nickthelegend/hotaru/solidworks/hotaru3-poses.png

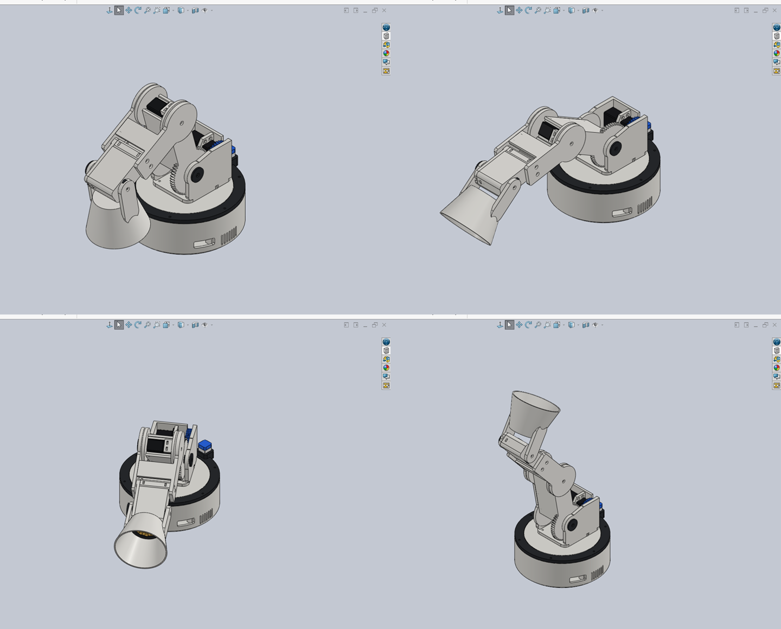
solidworks/hotaru3-poses.png
