nickthelegend/hotaru/solidworks/shots/Cap2200uF.png

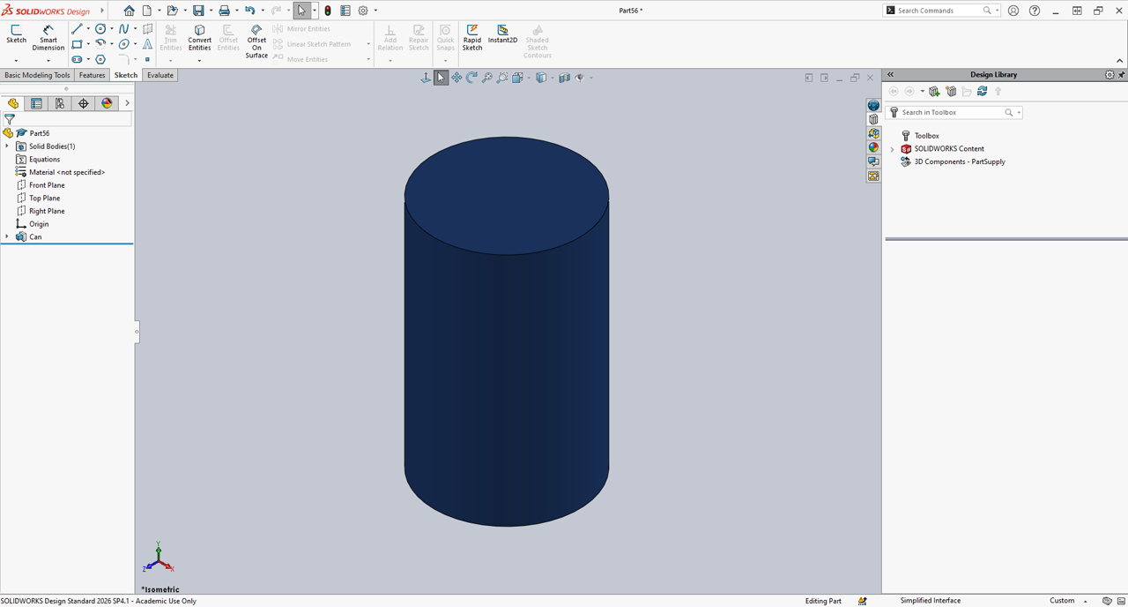
solidworks/shots/Cap2200uF.png
