nickthelegend/hotaru/solidworks/shots/CherryMX.png

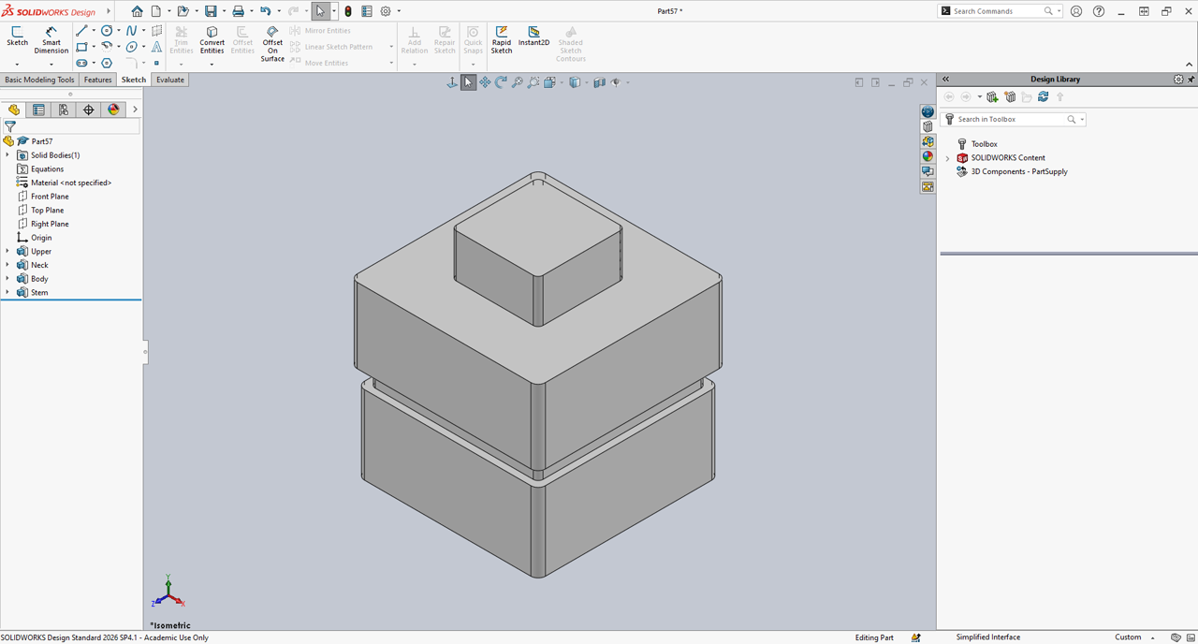
solidworks/shots/CherryMX.png
