nickthelegend/hotaru/solidworks/shots/ESP32-S3.png

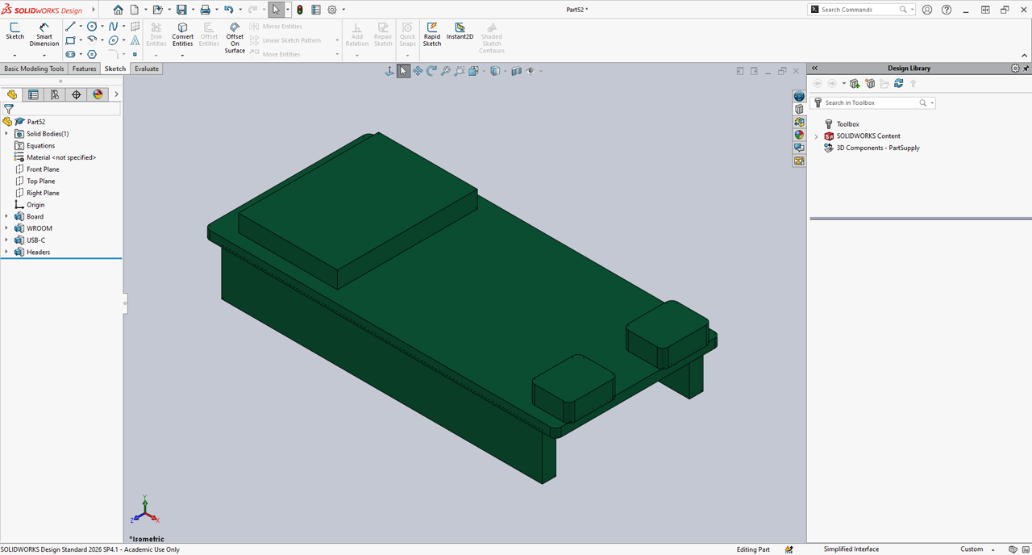
solidworks/shots/ESP32-S3.png
