nickthelegend/hotaru/solidworks/shots/h3-disc.png

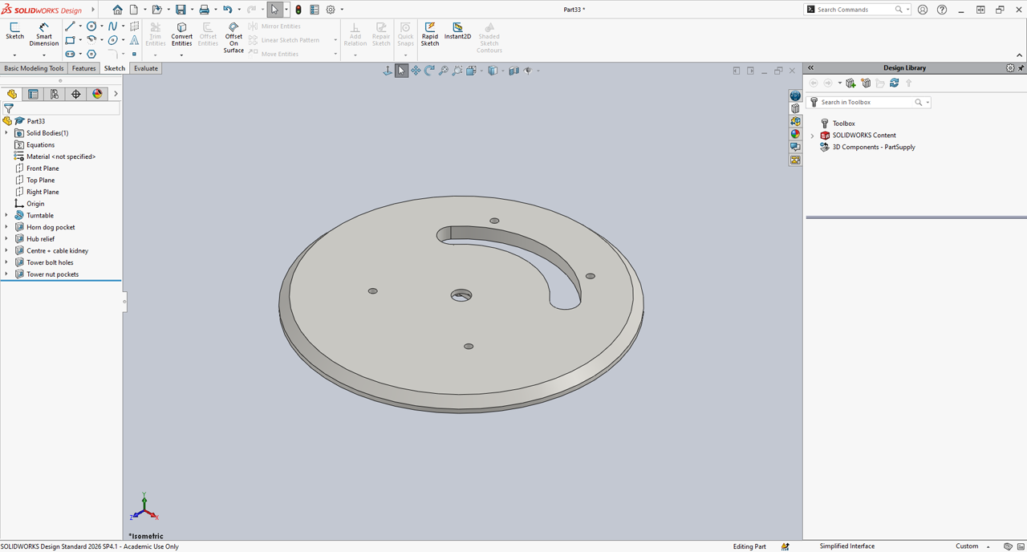
solidworks/shots/h3-disc.png
