nickthelegend/hotaru/solidworks/shots/h3-keycap.png

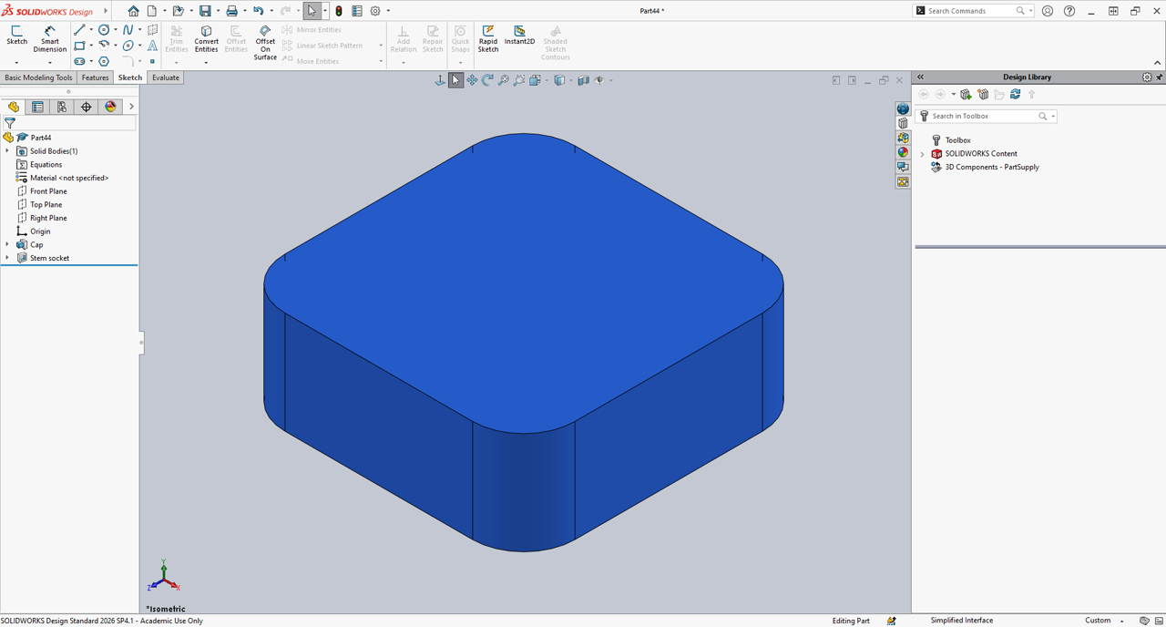
solidworks/shots/h3-keycap.png
