nickthelegend/hotaru/solidworks/shots/h3-lipring.png

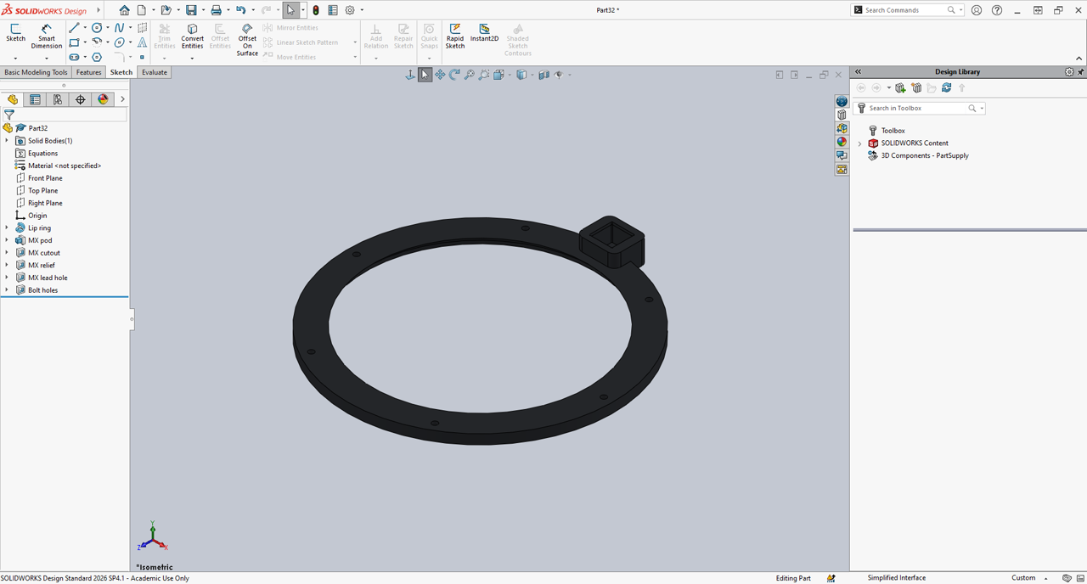
solidworks/shots/h3-lipring.png
