nickthelegend/hotaru/solidworks/shots/h3-pin-elbow.png

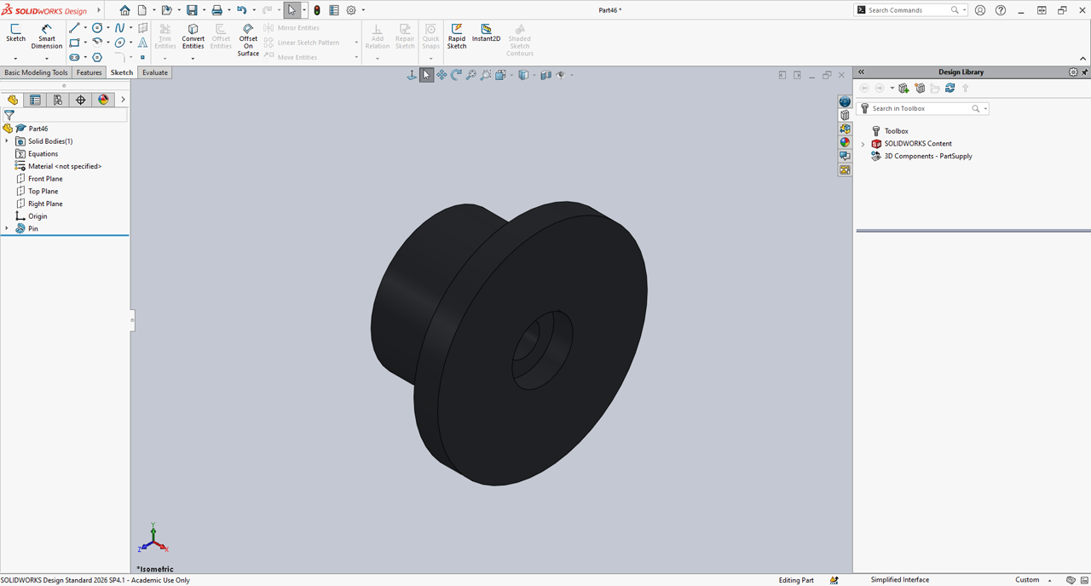
solidworks/shots/h3-pin-elbow.png
