nickthelegend/hotaru/solidworks/shots/h3-pinion.png

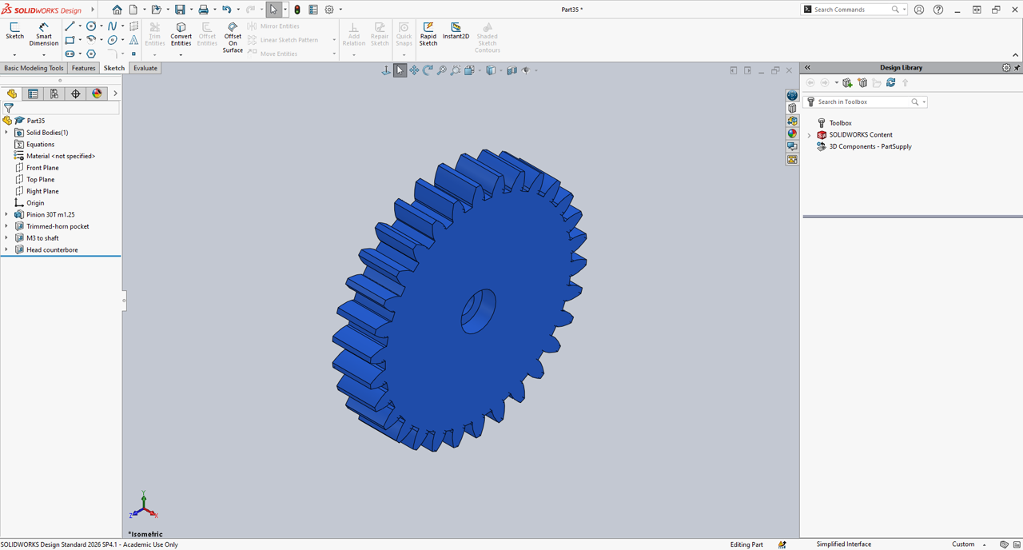
solidworks/shots/h3-pinion.png
