nickthelegend/hotaru/solidworks/shots/h3-tower-keeper.png

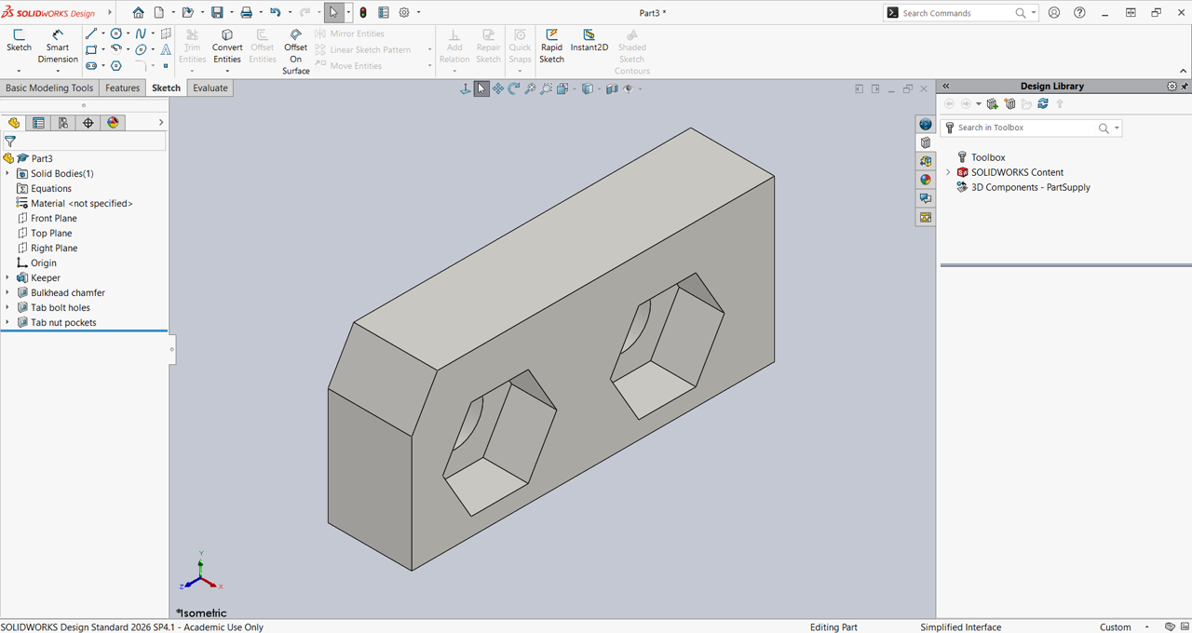
solidworks/shots/h3-tower-keeper.png
