nickthelegend/hotaru/solidworks/shots/h3-tower.png

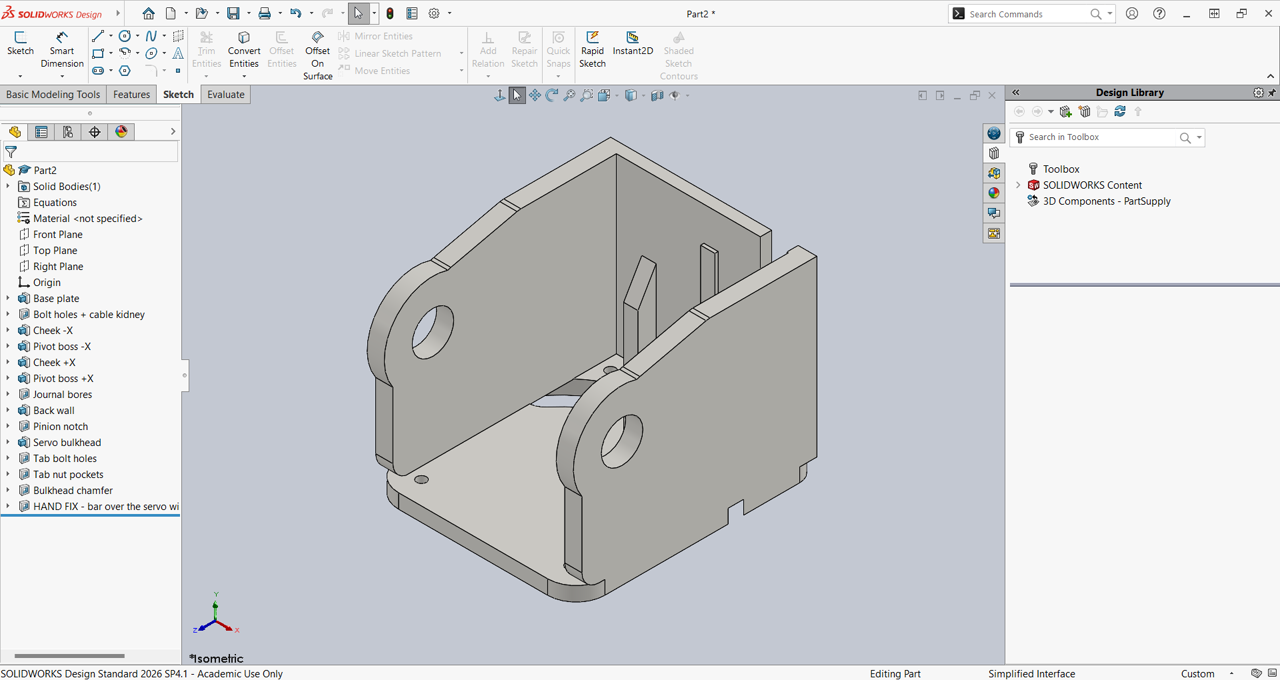
solidworks/shots/h3-tower.png
