nickthelegend/hotaru/solidworks/shots/h3-tub.png

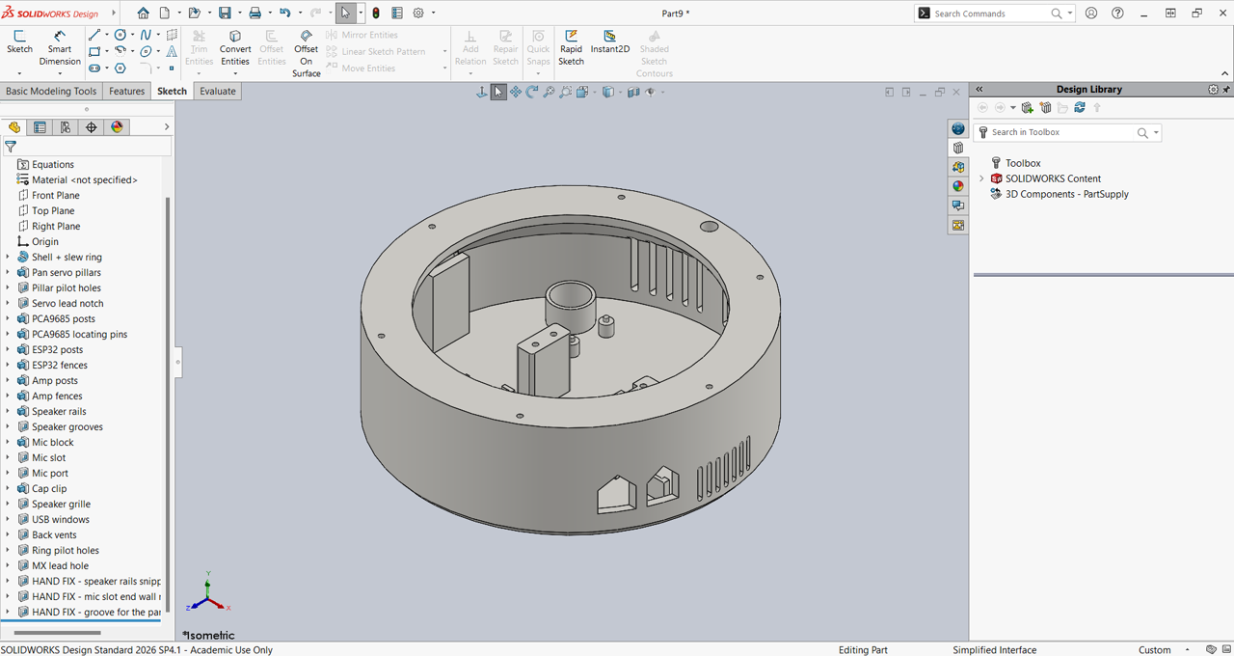
solidworks/shots/h3-tub.png
