nickthelegend/hotaru/solidworks/shots/Horn.png

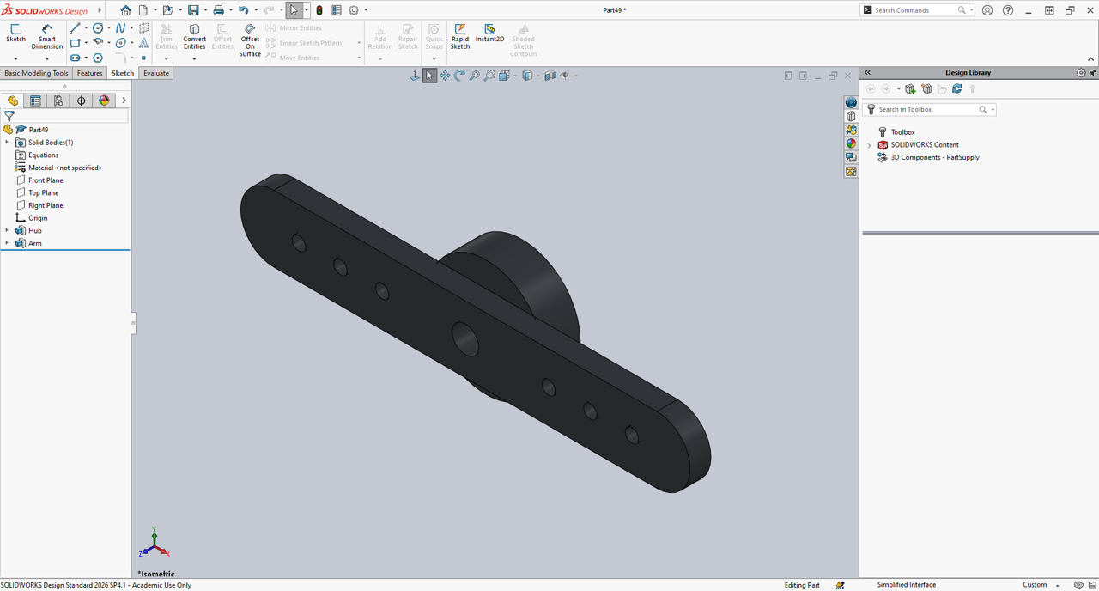
solidworks/shots/Horn.png
