nickthelegend/hotaru/solidworks/shots/HornTrim.png

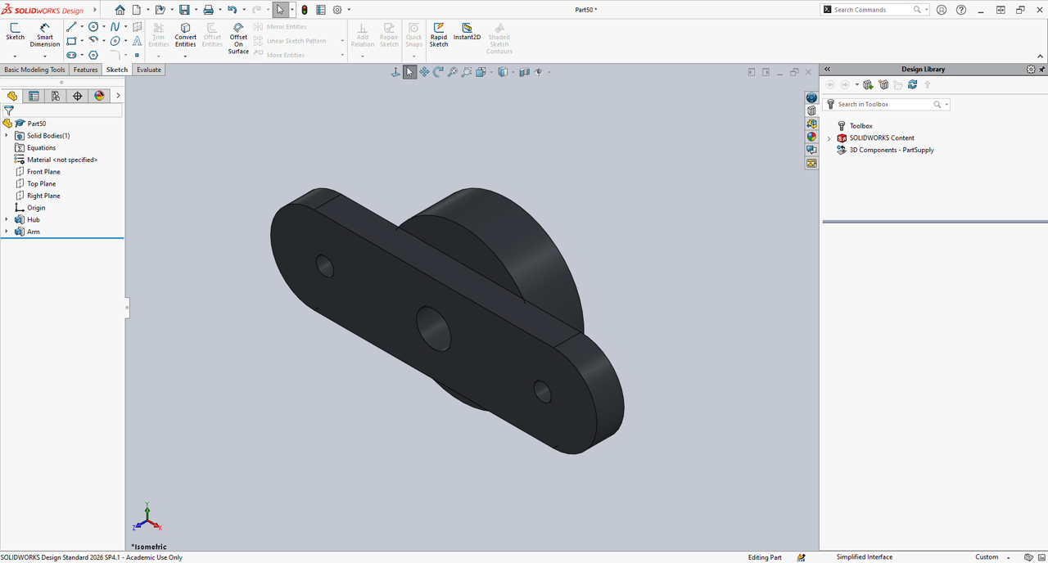
solidworks/shots/HornTrim.png
