nickthelegend/hotaru/solidworks/shots/M3-nut.png

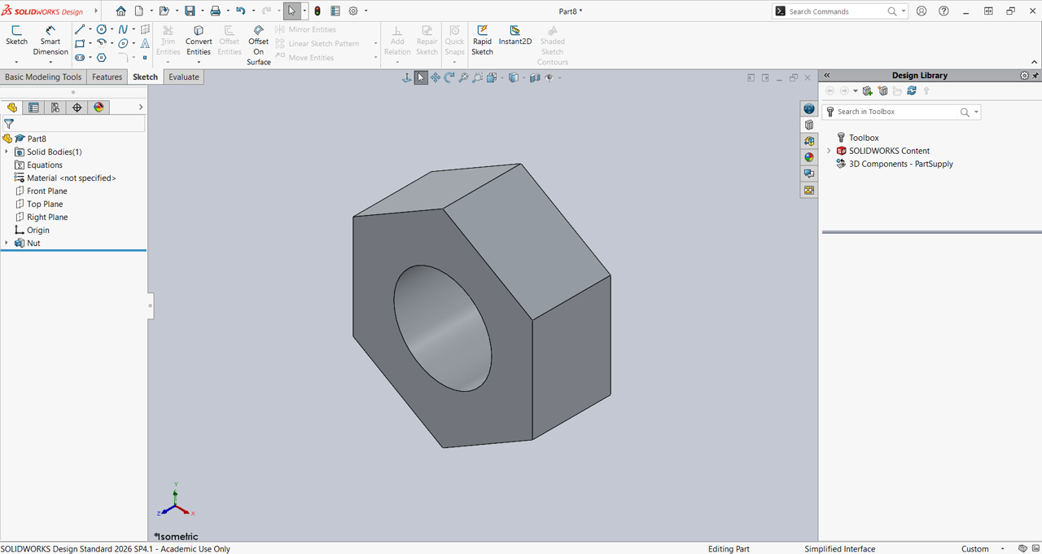
solidworks/shots/M3-nut.png
