nickthelegend/hotaru/solidworks/shots/M3x8.png

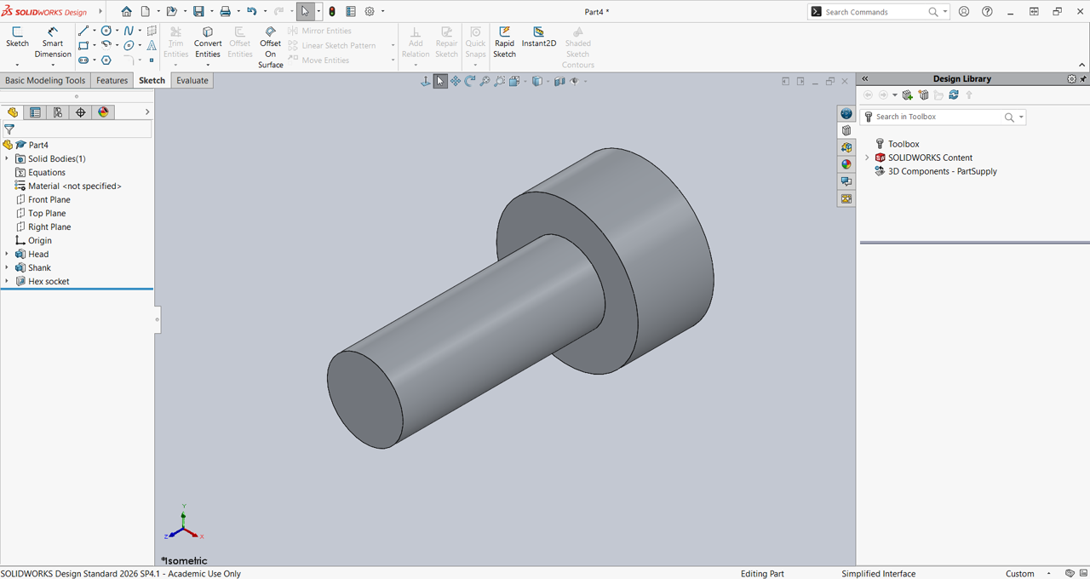
solidworks/shots/M3x8.png
