nickthelegend/hotaru/solidworks/shots/M3x12.png

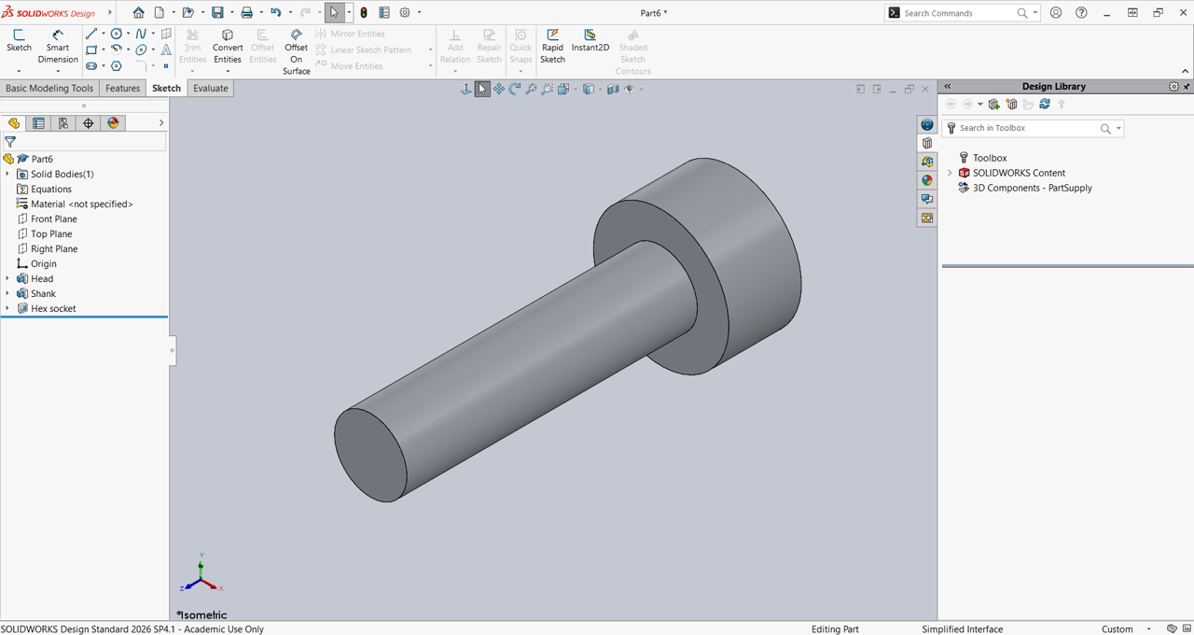
solidworks/shots/M3x12.png
