nickthelegend/hotaru/solidworks/shots/MAX98357A.png

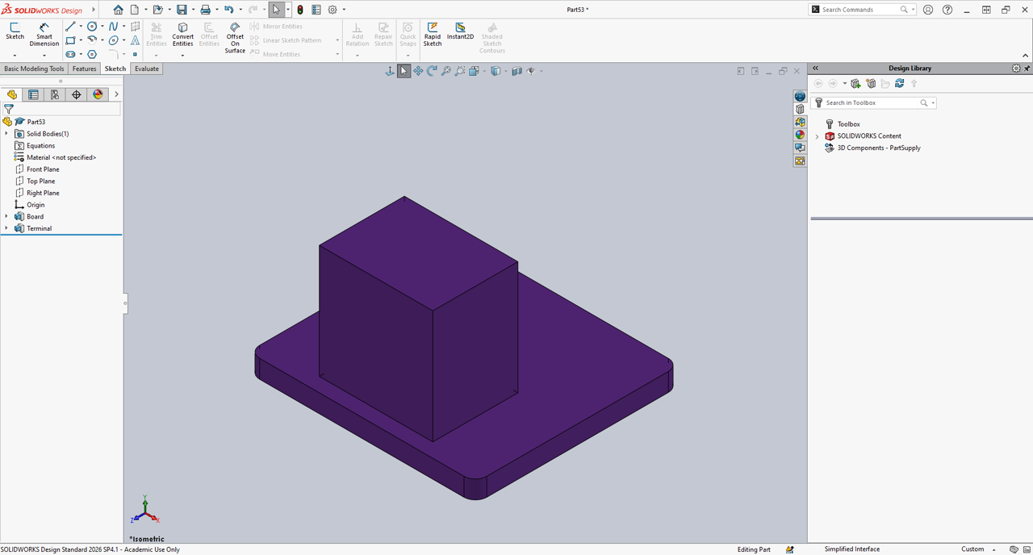
solidworks/shots/MAX98357A.png
