nickthelegend/hotaru/solidworks/shots/MG996R.png

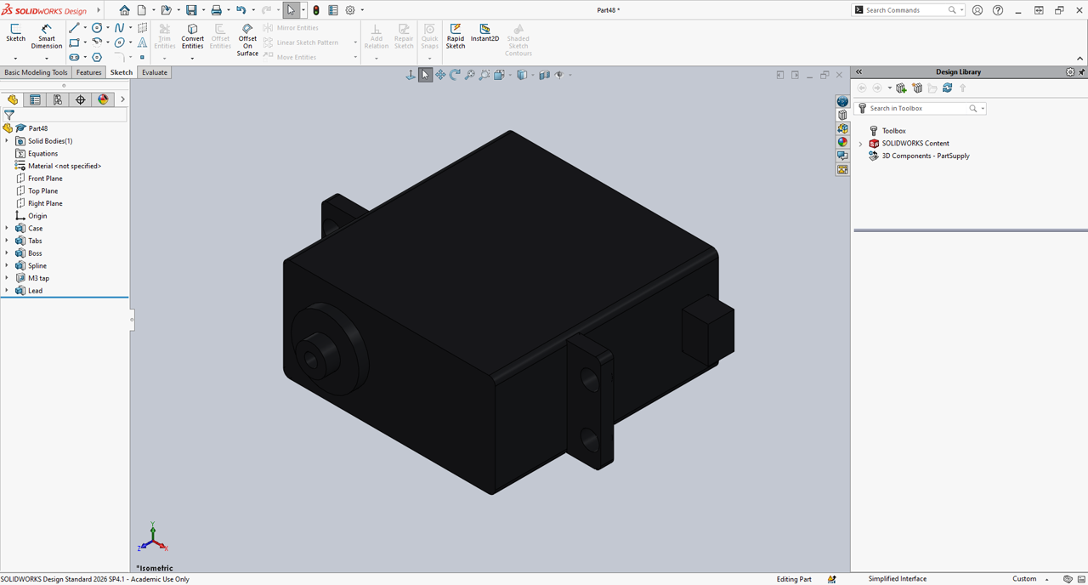
solidworks/shots/MG996R.png
