nickthelegend/hotaru/solidworks/shots/pose-curious.png

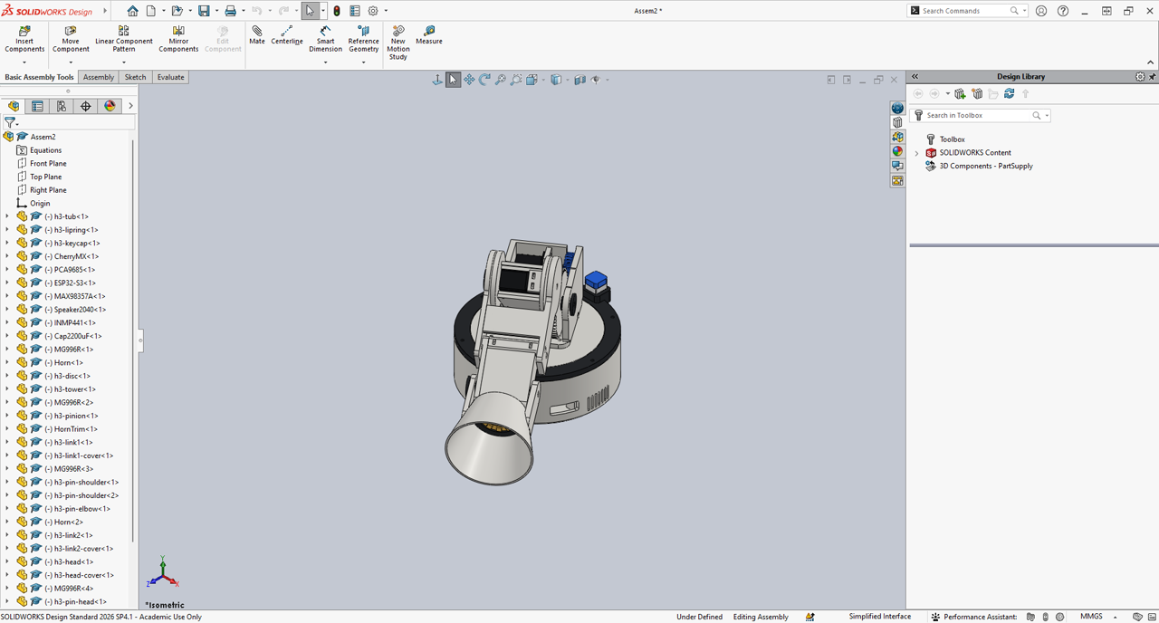
solidworks/shots/pose-curious.png
