nickthelegend/hotaru/solidworks/shots/pose-fold-back.png

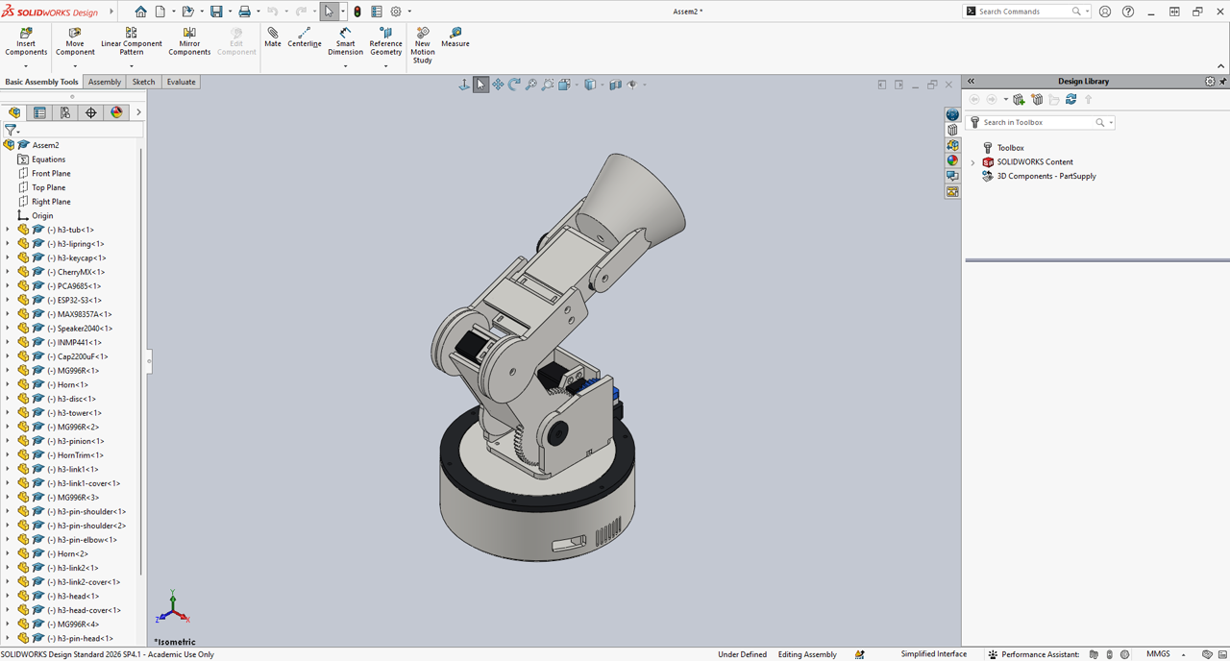
solidworks/shots/pose-fold-back.png
