nickthelegend/hotaru/solidworks/shots/pose-fold.png

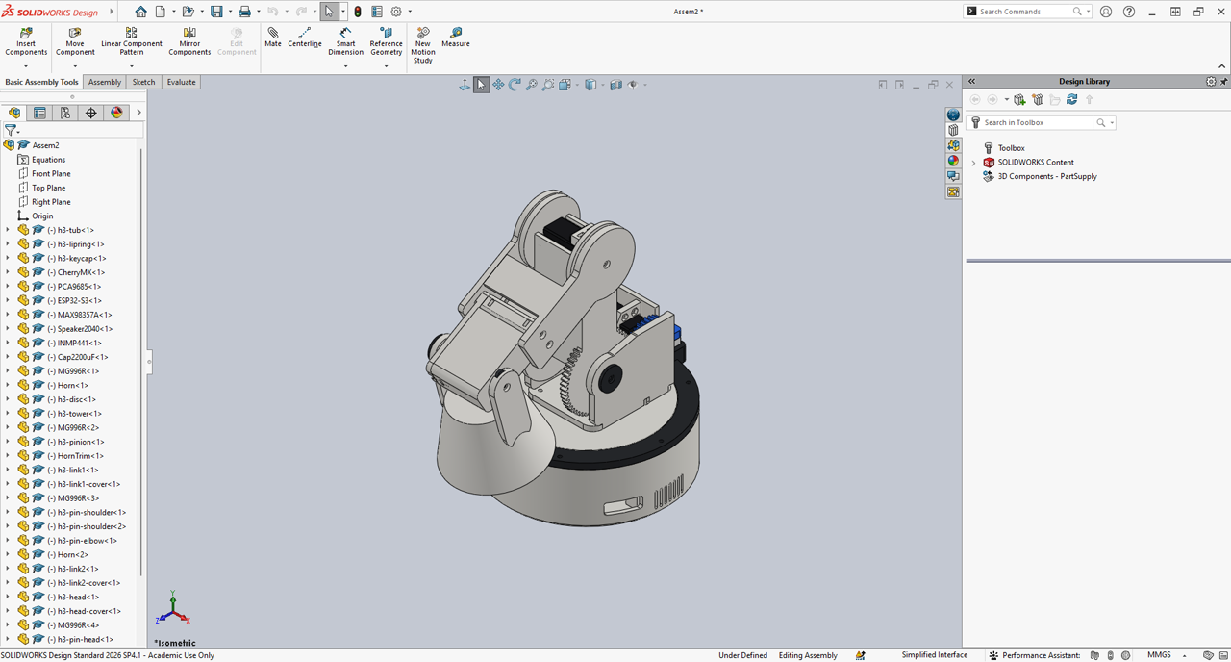
solidworks/shots/pose-fold.png
