nickthelegend/hotaru/solidworks/shots/pose-full-reach.png

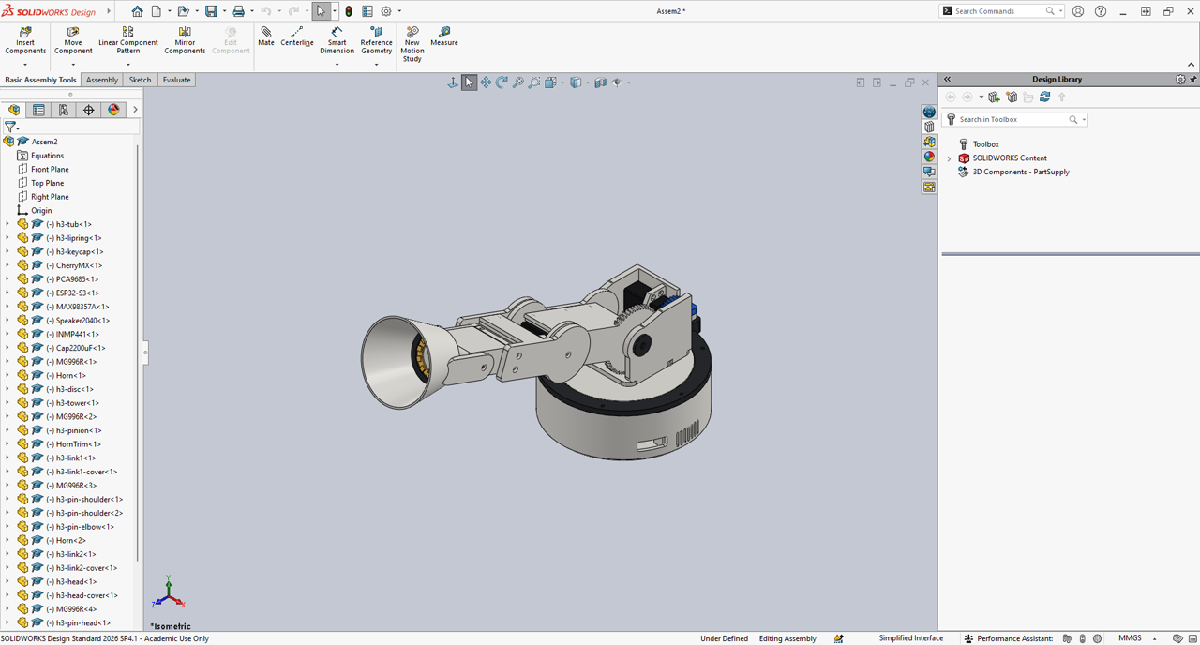
solidworks/shots/pose-full-reach.png
