nickthelegend/hotaru/solidworks/shots/pose-lean-back.png

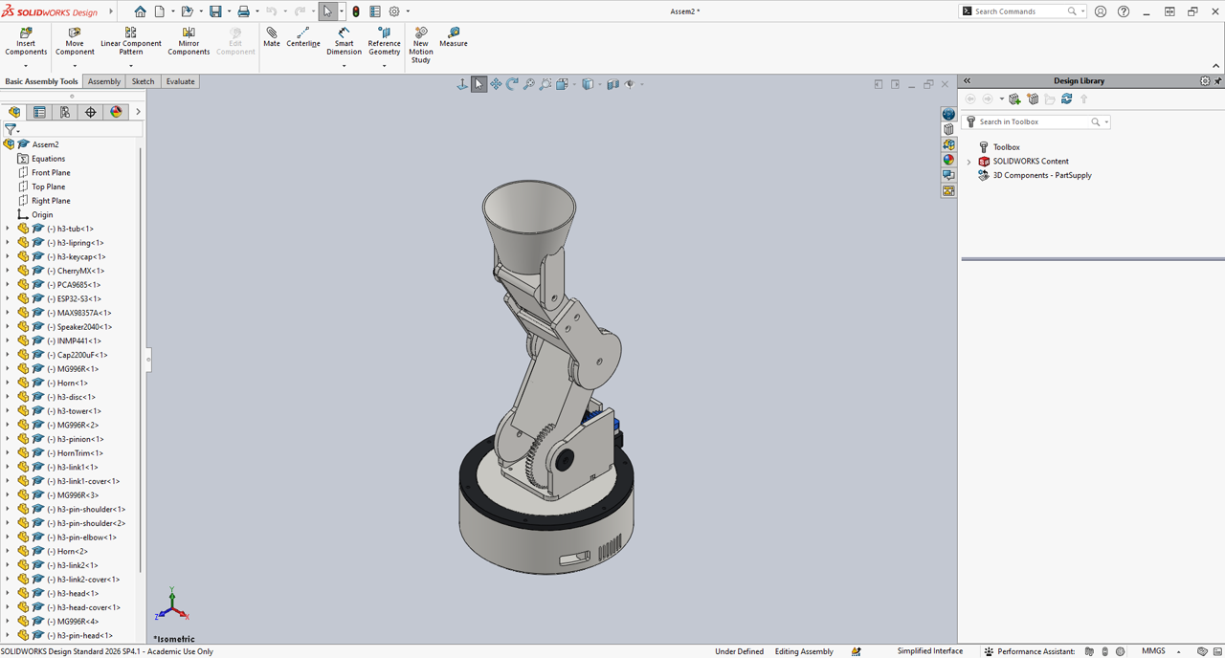
solidworks/shots/pose-lean-back.png
