nickthelegend/hotaru/solidworks/shots/Speaker2040.png

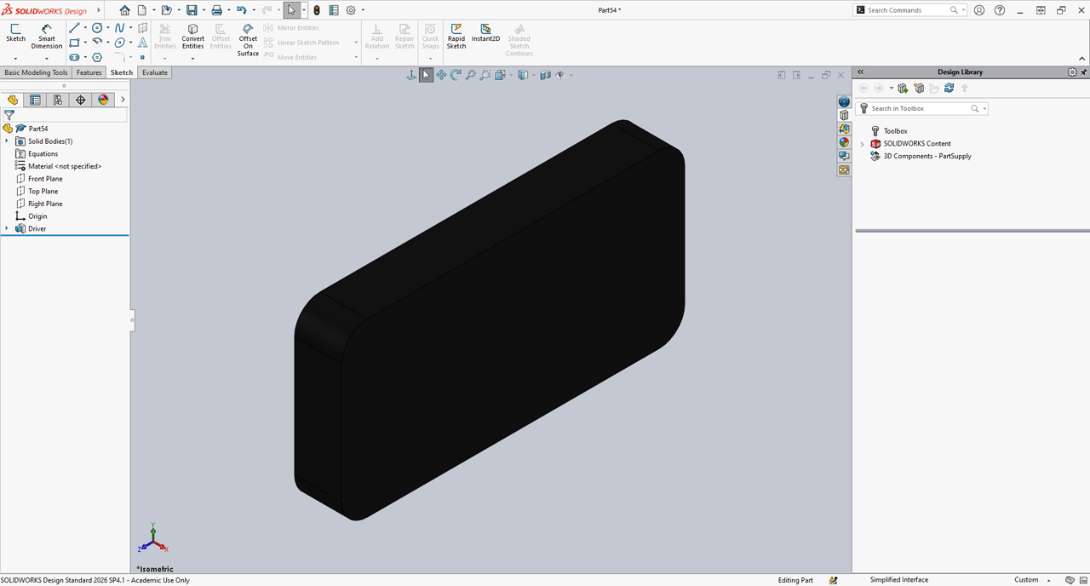
solidworks/shots/Speaker2040.png
