nickthelegend/hotaru/solidworks/HOTARU3.SLDASM

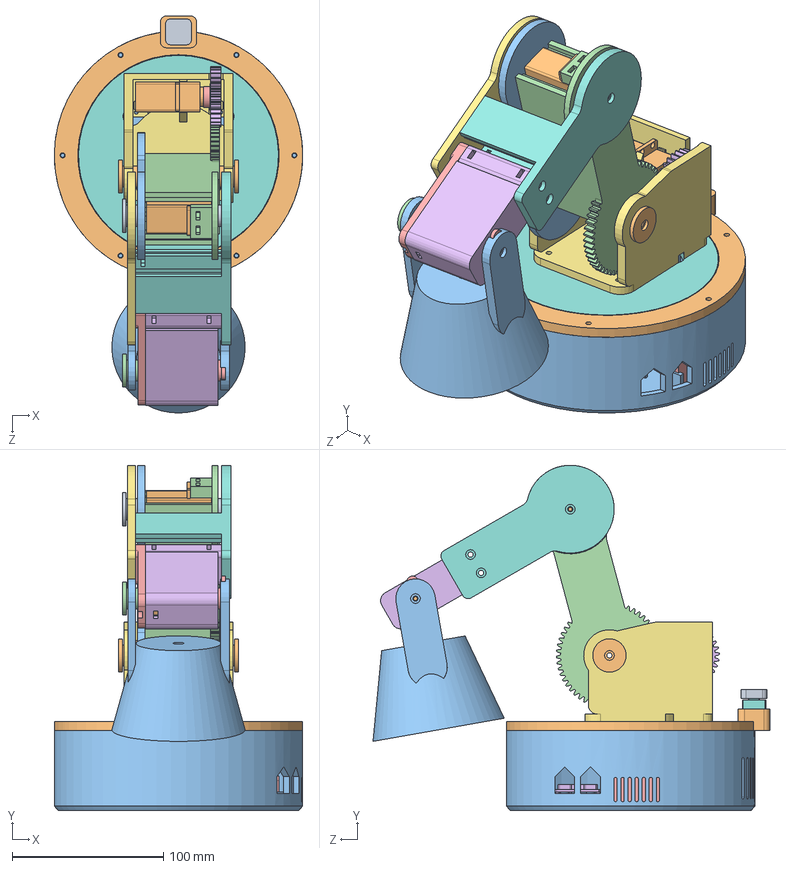
[picture p26: CAD file, 2026-09-24]
solidworks/HOTARU3.SLDASM
164.0 x 228.1 x 262.1 mm
h3-tub
h3-lipring
h3-keycap
CherryMX
PCA9685
ESP32-S3
Speaker2040
INMP441
Cap2200uF
MG996R x 4
Horn x 2
h3-disc
h3-tower
h3-pinion
HornTrim x 2
h3-link1
h3-link1-cover
h3-pin-shoulder x 2
h3-pin-elbow
h3-link2
h3-link2-cover
h3-head
h3-head-cover
h3-pin-head
h3-shade
WS2812-ring
h3-ledclamp
