nickthelegend/hotaru/exports/v3/h3-tub.STL

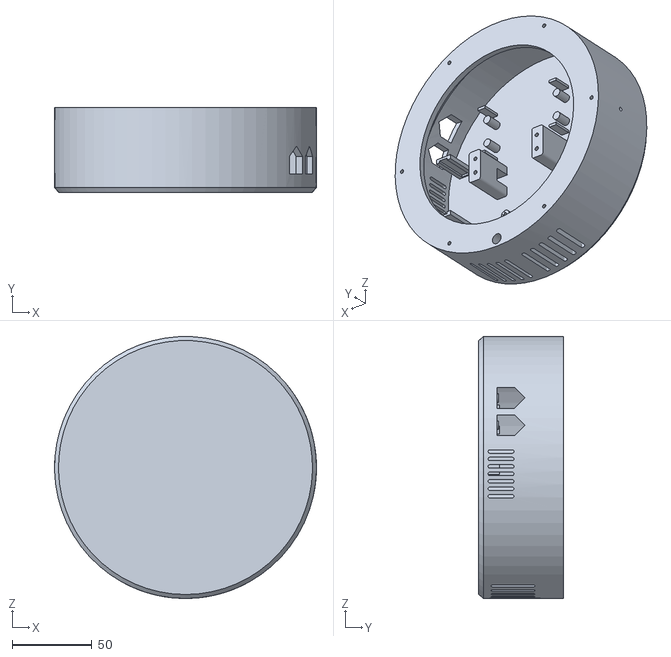
[picture p27: CAD file, 2026-10-16]
exports/v3/h3-tub.STL
164.0 x 53.0 x 164.0
