nickthelegend/hotaru/exports/v3/h3-head-cover.STL

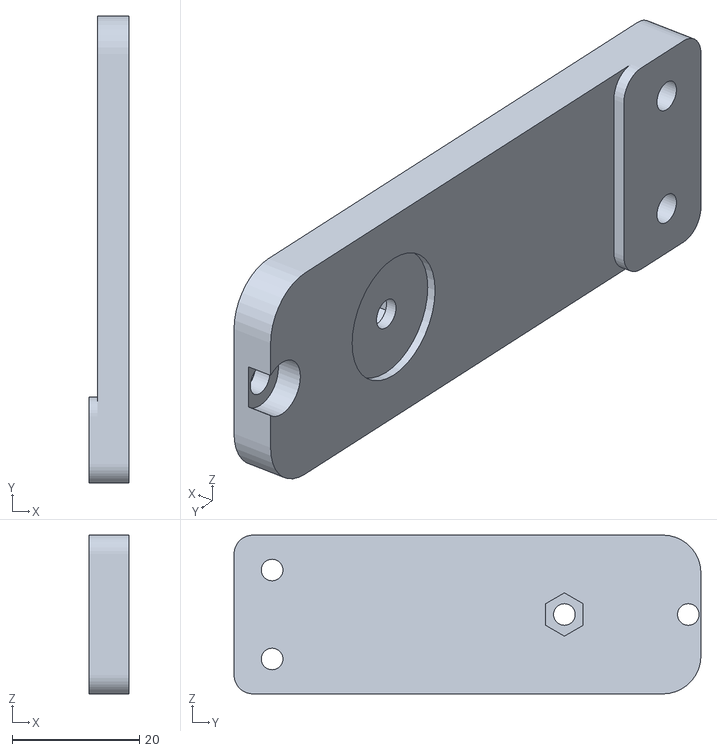
[picture p28: CAD file, 2026-09-24]
exports/v3/h3-head-cover.STL
6.35 x 73.5 x 25.0
