nickthelegend/hotaru/exports/v3/plates/HOTARU3-P1S-print-all.gcode.3mf

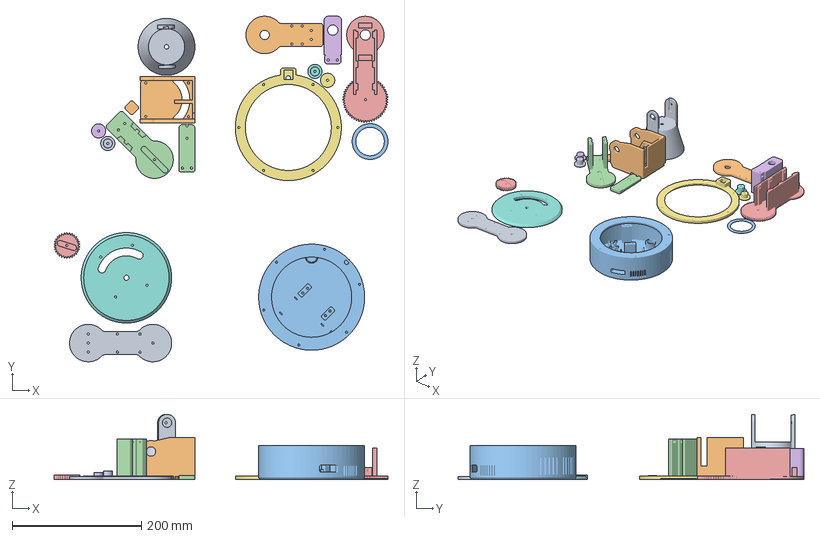
[picture p29: CAD file, 2026-10-16]
exports/v3/plates/HOTARU3-P1S-print-all.gcode.3mf
516.1 x 534.1 x 101.0 mm
h3-shade.stl
h3-tower.stl
h3-tub.stl
h3-link2.stl
h3-link1.stl
h3-head.stl
h3-lipring.stl
h3-disc.stl
h3-link1-cover.stl
h3-link2-cover.stl
h3-ledclamp.stl
h3-head-cover.stl
h3-pinion.stl
h3-pin-elbow.stl
h3-pin-head.stl
h3-pin-shoulder.stl x 2
h3-keycap.stl
