nickthelegend/hotaru/exports/v3/h3-link2.STL

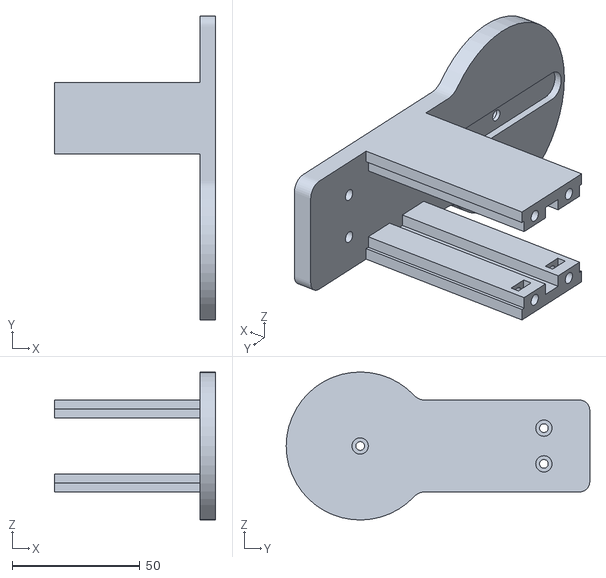
[picture p30: CAD file, 2026-09-24]
exports/v3/h3-link2.STL
63.1 x 119.0 x 58.0
