nickthelegend/hotaru/exports/v3/h3-ledclamp.STL

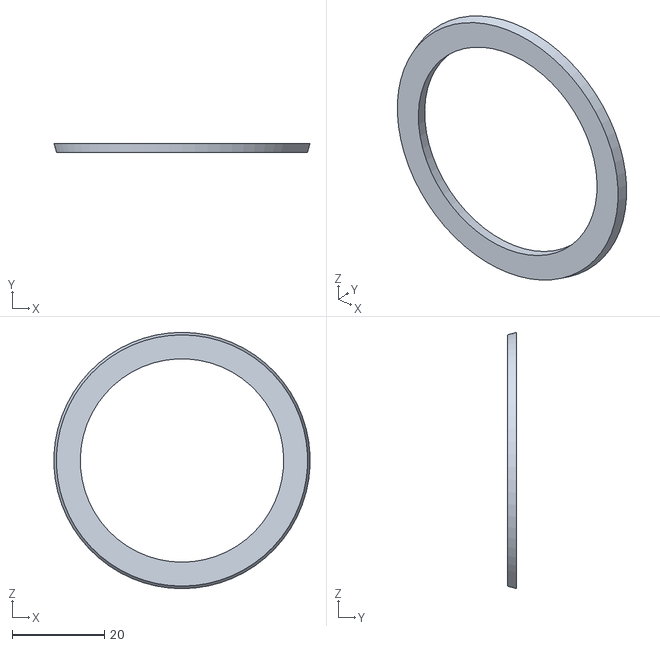
[picture p31: CAD file, 2026-09-24]
exports/v3/h3-ledclamp.STL
55.4 x 2.00 x 55.5
