nickthelegend/hotaru/exports/v3/h3-shade.STL

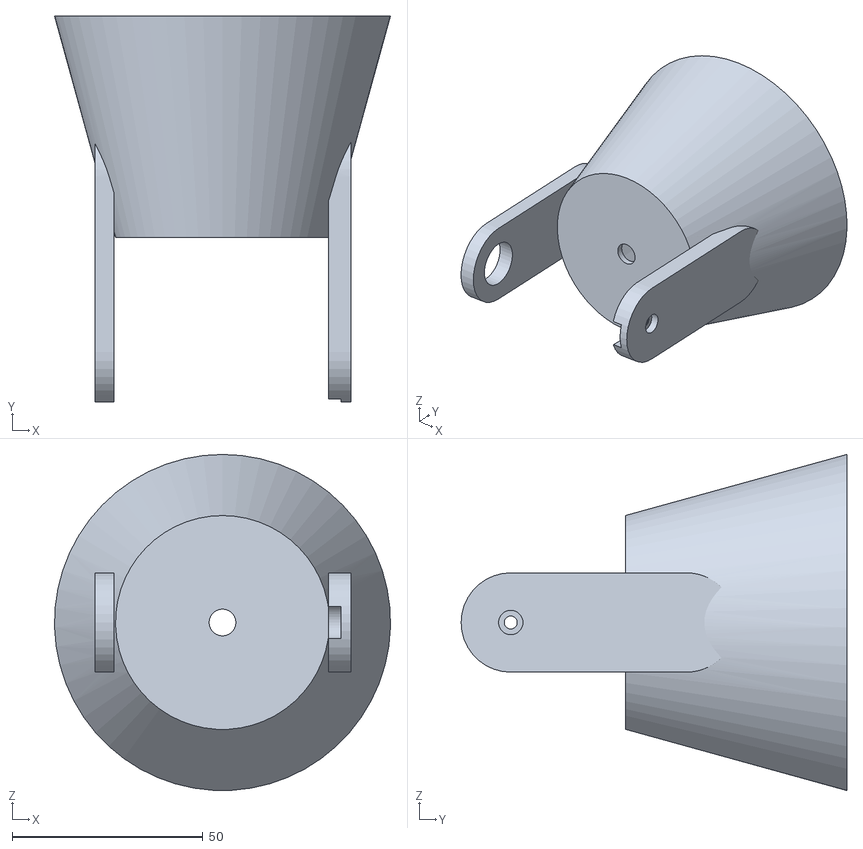
[picture p32: CAD file, 2026-09-24]
exports/v3/h3-shade.STL
88.0 x 101.0 x 88.0
