nickthelegend/hotaru/solidworks/parts/h3-tower-keeper.SLDPRT

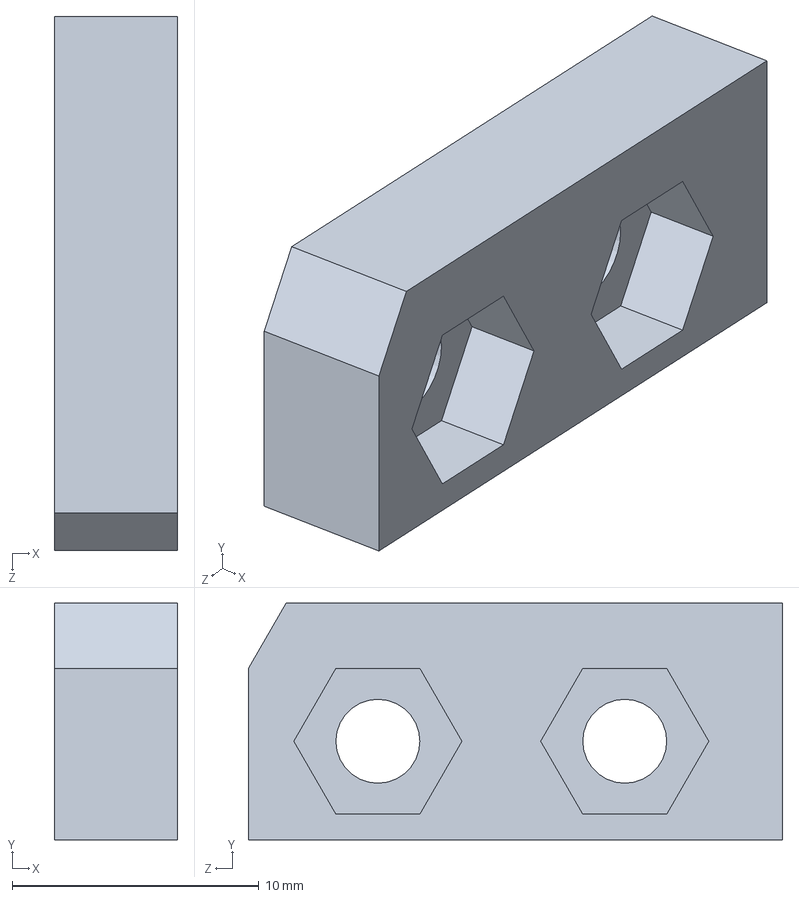
[picture p33: CAD file, 2026-10-16]
solidworks/parts/h3-tower-keeper.SLDPRT
5.00 x 9.60 x 21.7 mm
