nickthelegend/hotaru/exports/v3/h3-pinion.STL

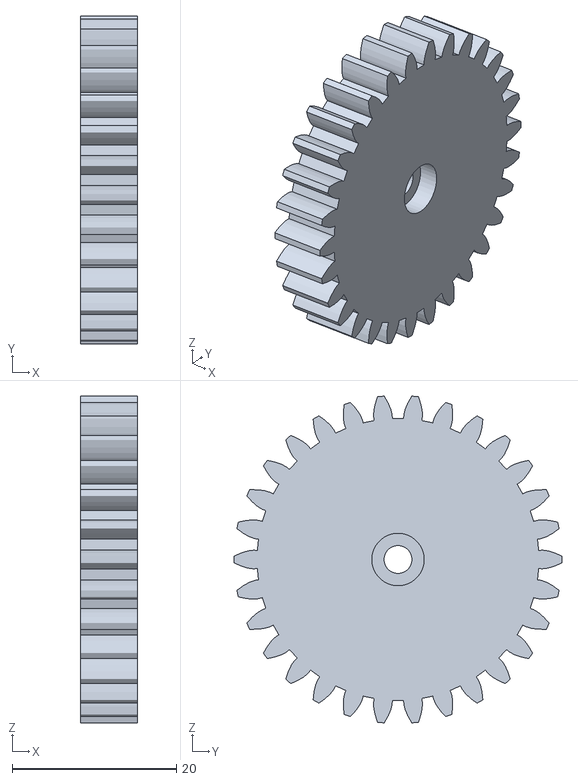
[picture p34: CAD file, 2026-09-24]
exports/v3/h3-pinion.STL
7.00 x 40.0 x 39.9
