nickthelegend/hotaru/exports/v3/plates/plate-3-turntable.3mf

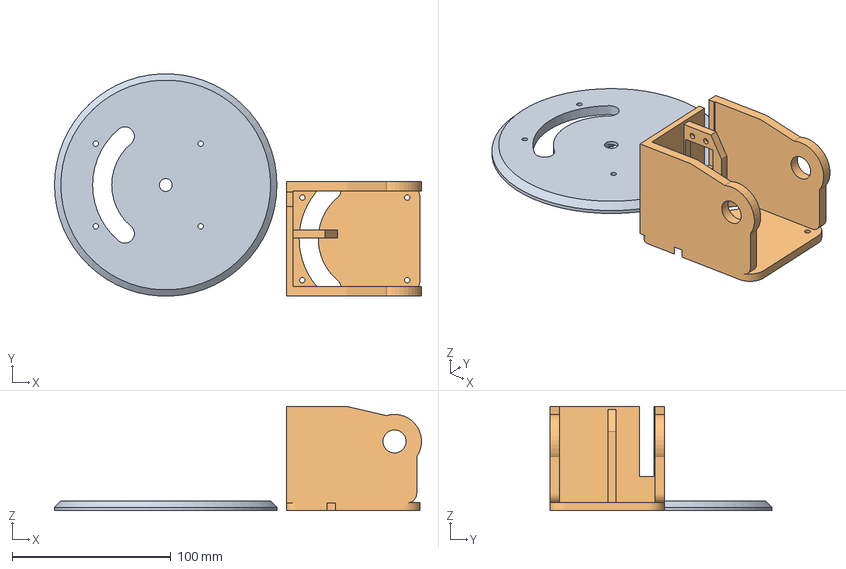
[picture p35: CAD file, 2026-09-24]
exports/v3/plates/plate-3-turntable.3mf
231.0 x 139.8 x 65.5 mm
h3-disc
h3-tower
