nickthelegend/hotaru/exports/v3/h3-tower.STL

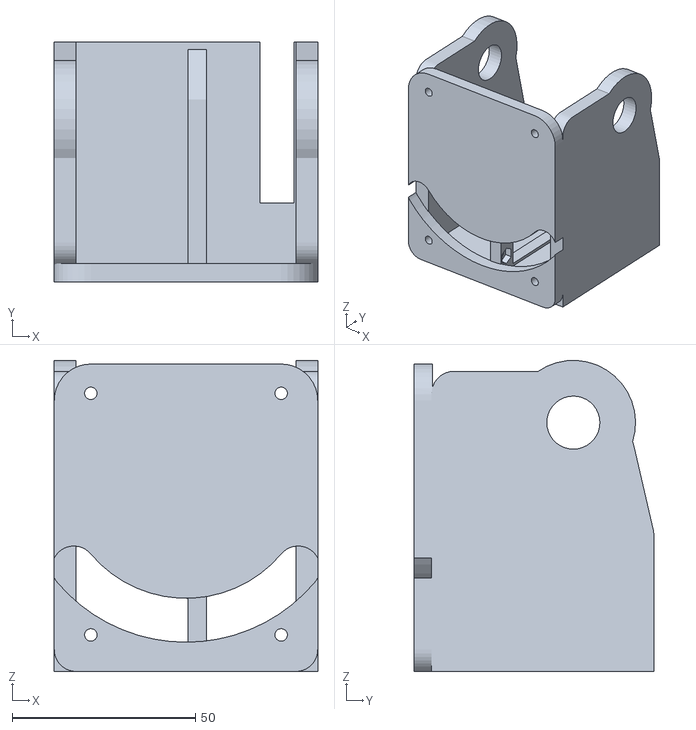
[picture p36: CAD file, 2026-09-24]
exports/v3/h3-tower.STL
72.0 x 65.5 x 85.0
