nickthelegend/hotaru/exports/v3/plates/plate-4-arm.3mf

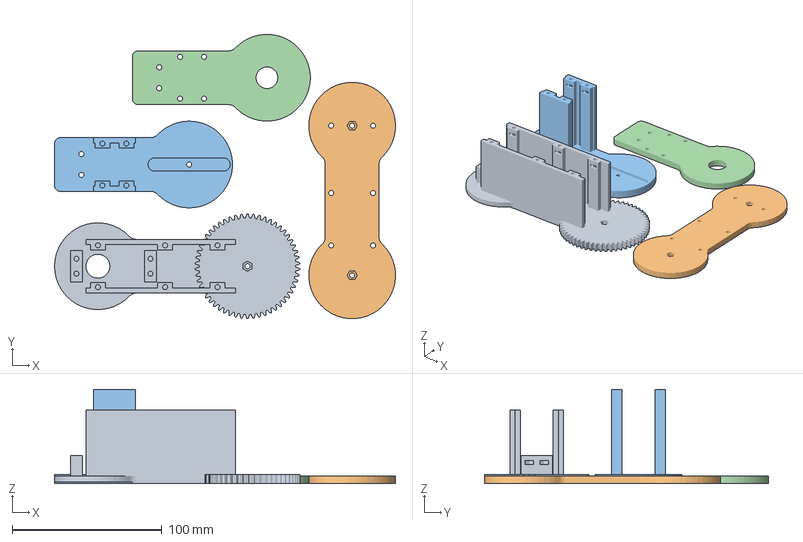
[picture p37: CAD file, 2026-09-24]
exports/v3/plates/plate-4-arm.3mf
227.9 x 190.0 x 63.1 mm
h3-link1
h3-link1-cover
h3-link2
h3-link2-cover
