nickthelegend/hotaru/solidworks/parts/h3-tub.SLDPRT

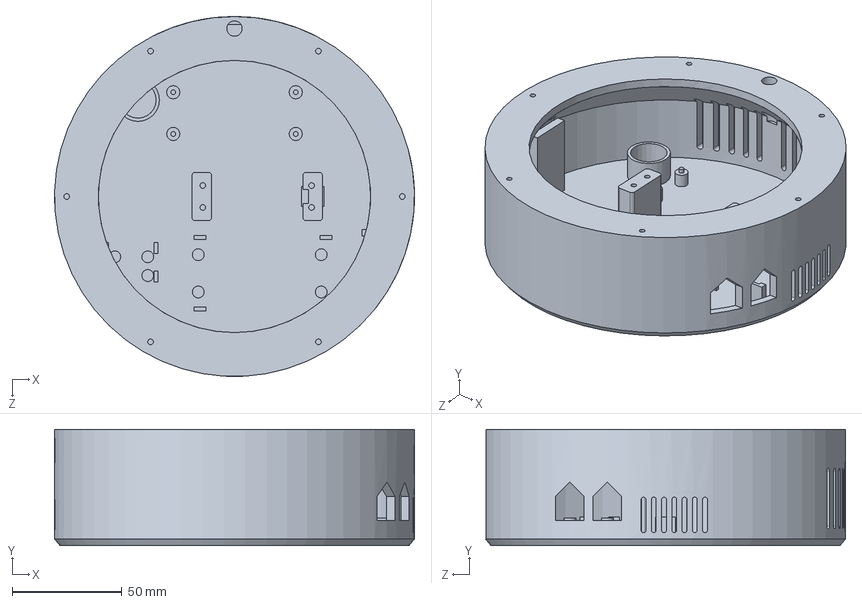
[picture p38: CAD file, 2026-10-16]
solidworks/parts/h3-tub.SLDPRT
164.0 x 53.0 x 164.0 mm
