nickthelegend/hotaru/exports/v3/h3-link1-cover.STL

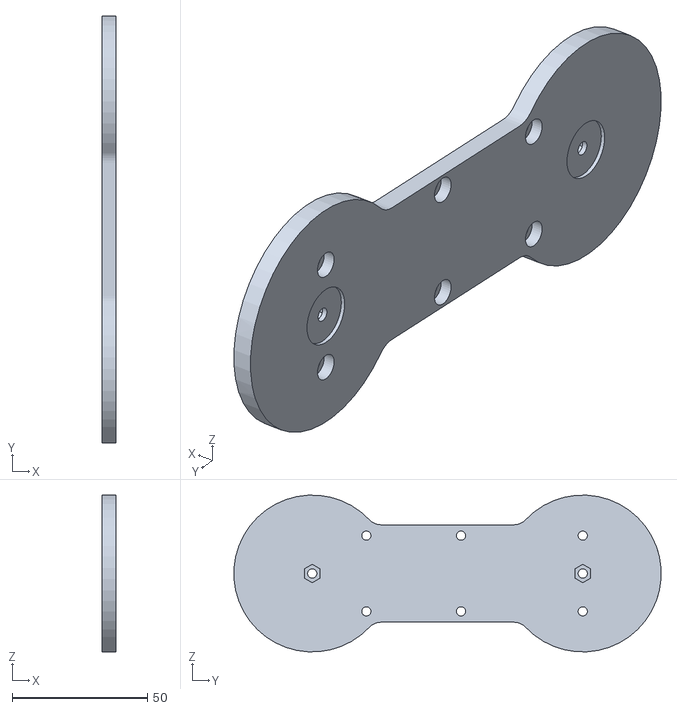
[picture p39: CAD file, 2026-09-24]
exports/v3/h3-link1-cover.STL
5.00 x 157.8 x 57.9
