nickthelegend/hotaru/exports/v3/plates/plate-2-lipring-and-pins.3mf

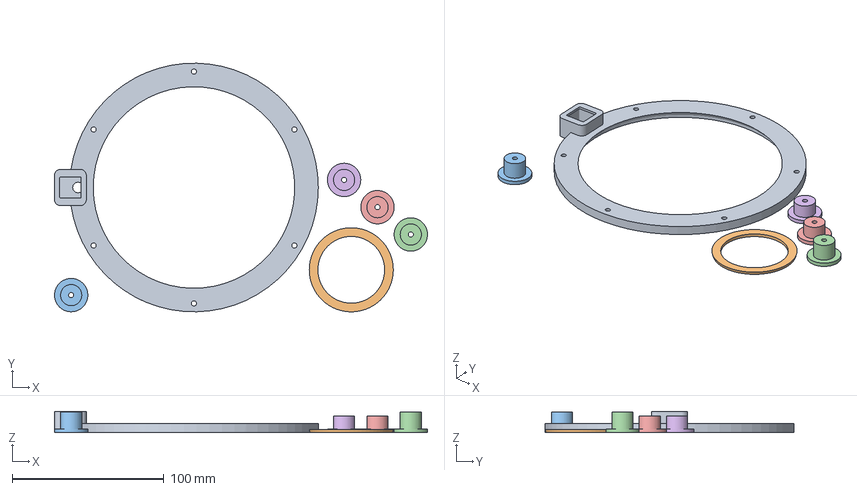
[picture p40: CAD file, 2026-09-24]
exports/v3/plates/plate-2-lipring-and-pins.3mf
246.0 x 164.0 x 14.0 mm
h3-lipring
h3-ledclamp
h3-pin-shoulder-1
h3-pin-shoulder-2
h3-pin-elbow
h3-pin-head
