nickthelegend/hotaru/solidworks/parts/h3-tower.SLDPRT

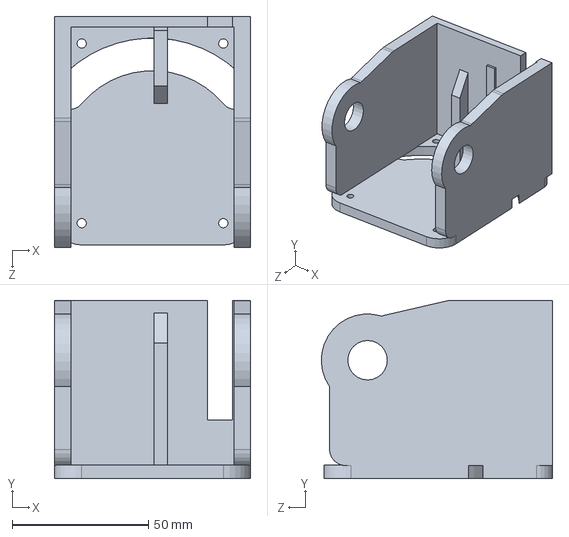
[picture p41: CAD file, 2026-10-16]
solidworks/parts/h3-tower.SLDPRT
72.0 x 65.5 x 85.0 mm
