nickthelegend/hotaru/exports/v3/h3-keycap.STL

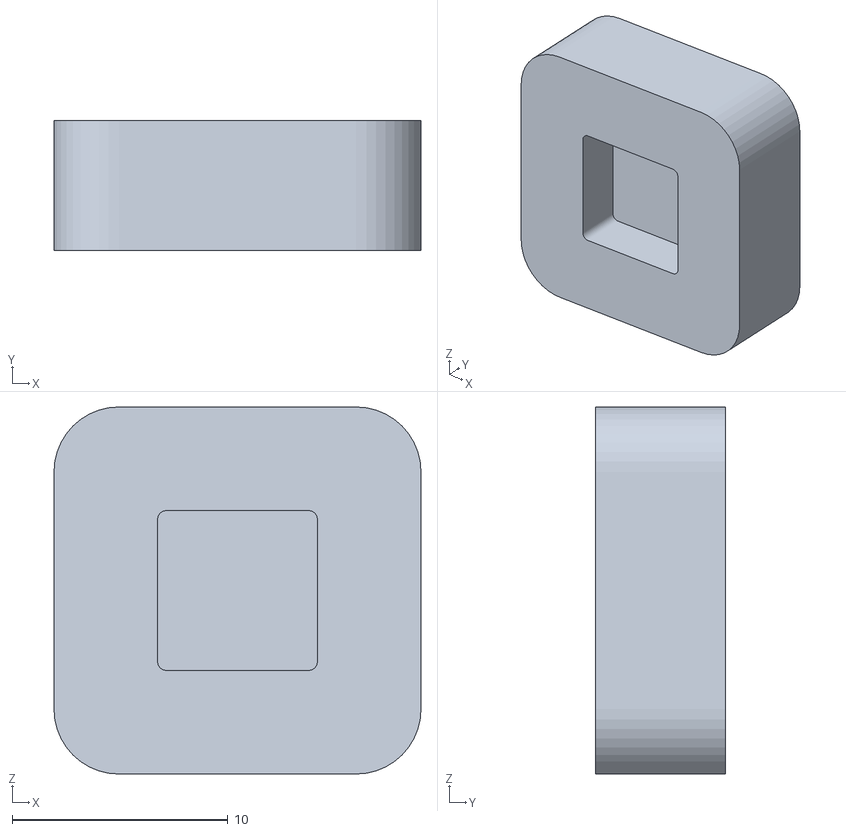
[picture p42: CAD file, 2026-09-24]
exports/v3/h3-keycap.STL
17.0 x 6.00 x 17.0
