nickthelegend/hotaru/exports/v3/plates/plate-5-head-and-shade.3mf

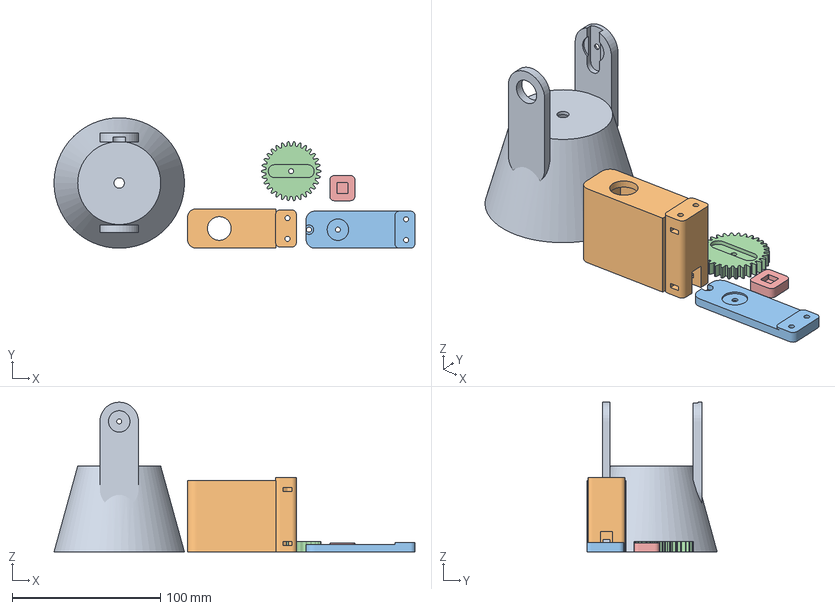
[picture p43: CAD file, 2026-09-24]
exports/v3/plates/plate-5-head-and-shade.3mf
243.5 x 88.0 x 101.0 mm
h3-shade
h3-head
h3-head-cover
h3-pinion
h3-keycap
