nickthelegend/hotaru/solidworks/parts/h3-head.SLDPRT

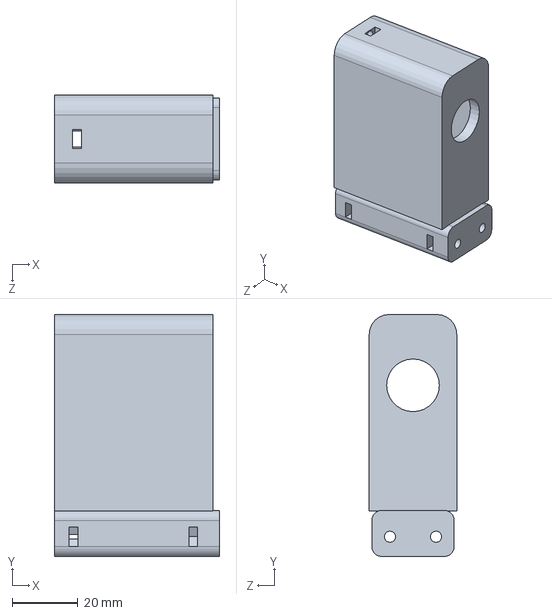
[picture p44: CAD file, 2026-09-24]
solidworks/parts/h3-head.SLDPRT
50.1 x 73.5 x 26.6 mm
