nickthelegend/hotaru/exports/v3/h3-pin-head.STL

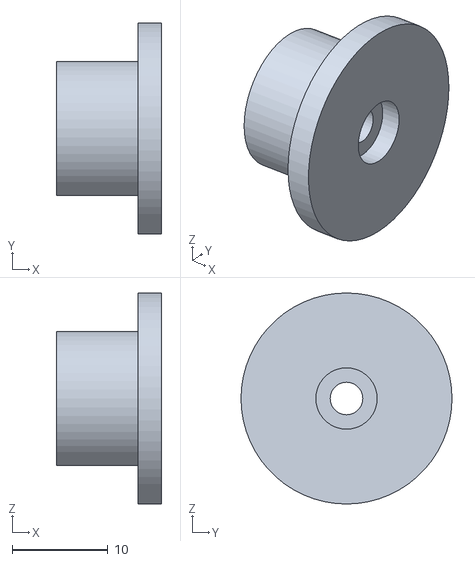
[picture p45: CAD file, 2026-09-24]
exports/v3/h3-pin-head.STL
11.0 x 22.0 x 22.0
