nickthelegend/hotaru/solidworks/parts/Cap2200uF.SLDPRT

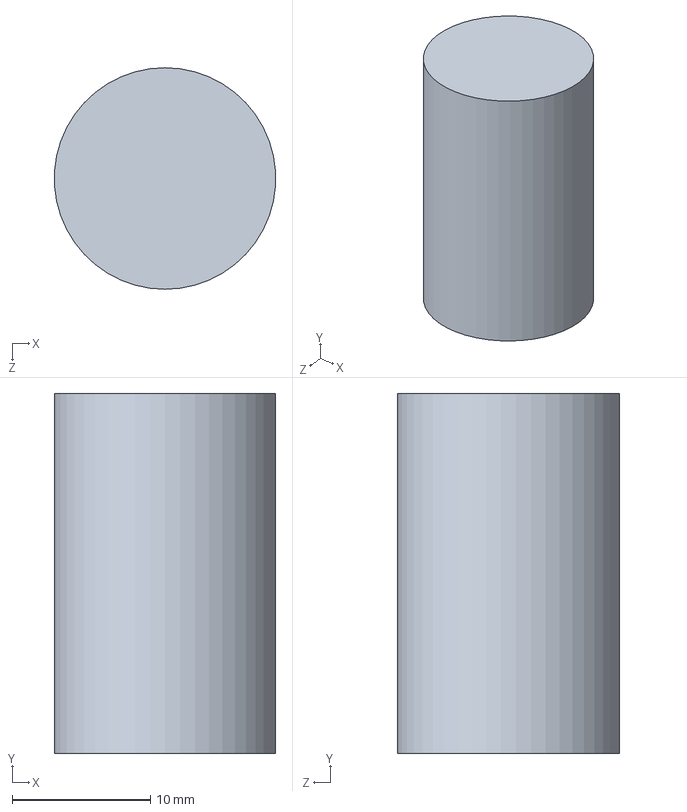
[picture p46: CAD file, 2026-09-24]
solidworks/parts/Cap2200uF.SLDPRT
16.0 x 26.0 x 16.0 mm
