nickthelegend/hotaru/exports/v3/h3-lipring.STL

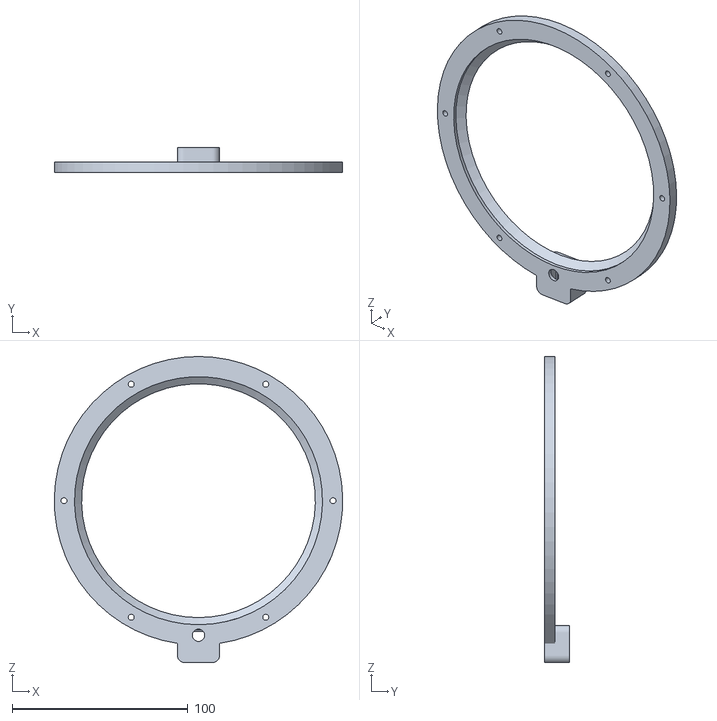
[picture p47: CAD file, 2026-09-24]
exports/v3/h3-lipring.STL
164.0 x 14.0 x 174.0
