nickthelegend/hotaru/solidworks/parts/h3-link2-cover.SLDPRT

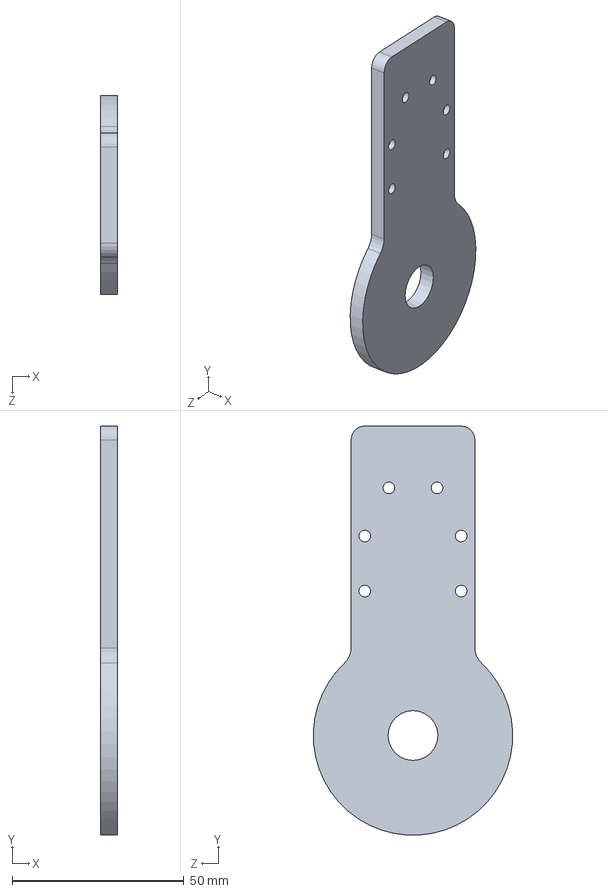
[picture p48: CAD file, 2026-09-24]
solidworks/parts/h3-link2-cover.SLDPRT
5.00 x 118.9 x 58.0 mm
