nickthelegend/hotaru/exports/v3/h3-disc.STL

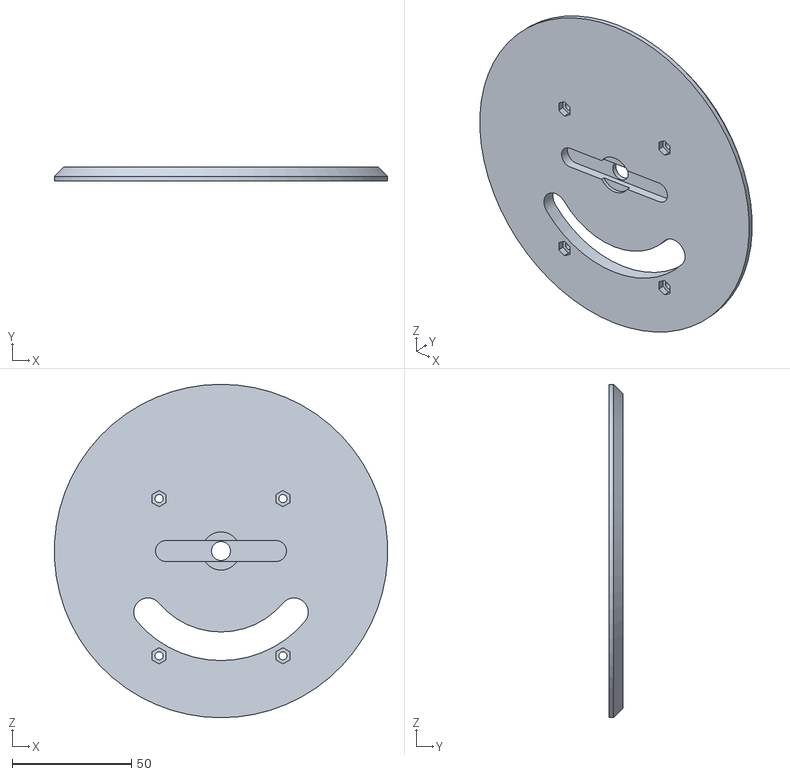
[picture p49: CAD file, 2026-09-24]
exports/v3/h3-disc.STL
139.8 x 6.00 x 140.0
