nickthelegend/hotaru/solidworks/parts/HornTrim.SLDPRT

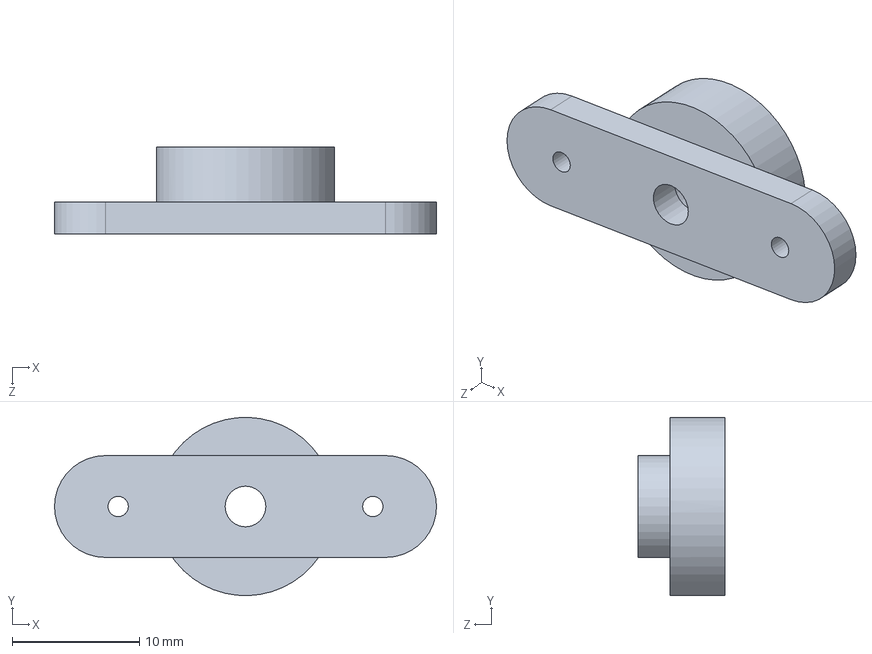
[picture p50: CAD file, 2026-09-24]
solidworks/parts/HornTrim.SLDPRT
30.0 x 14.0 x 6.80 mm
