nickthelegend/hotaru/exports/v3/h3-link1.STL

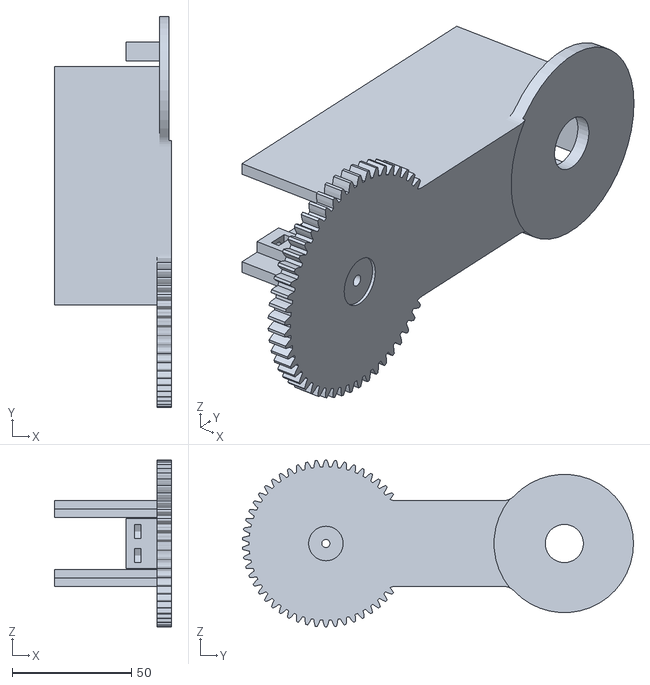
[picture p51: CAD file, 2026-09-24]
exports/v3/h3-link1.STL
49.1 x 164.0 x 70.0
