nickthelegend/hotaru/solidworks/parts/CherryMX.SLDPRT

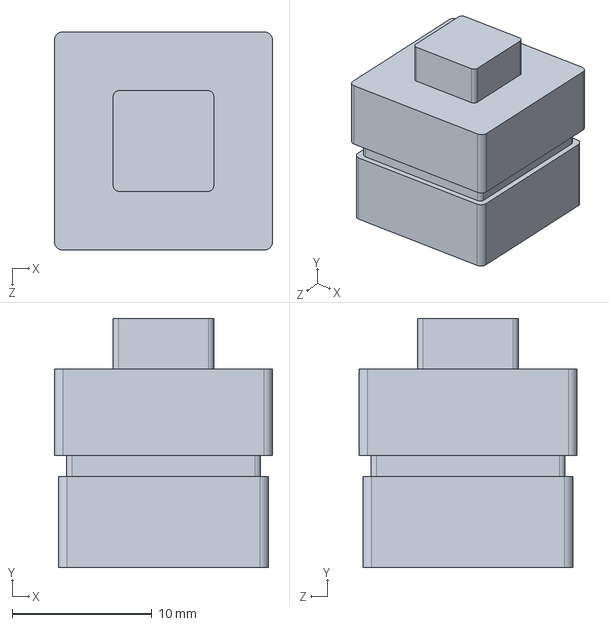
[picture p52: CAD file, 2026-09-24]
solidworks/parts/CherryMX.SLDPRT
15.6 x 17.8 x 15.6 mm
