nickthelegend/hotaru/exports/v3/h3-pin-shoulder.STL

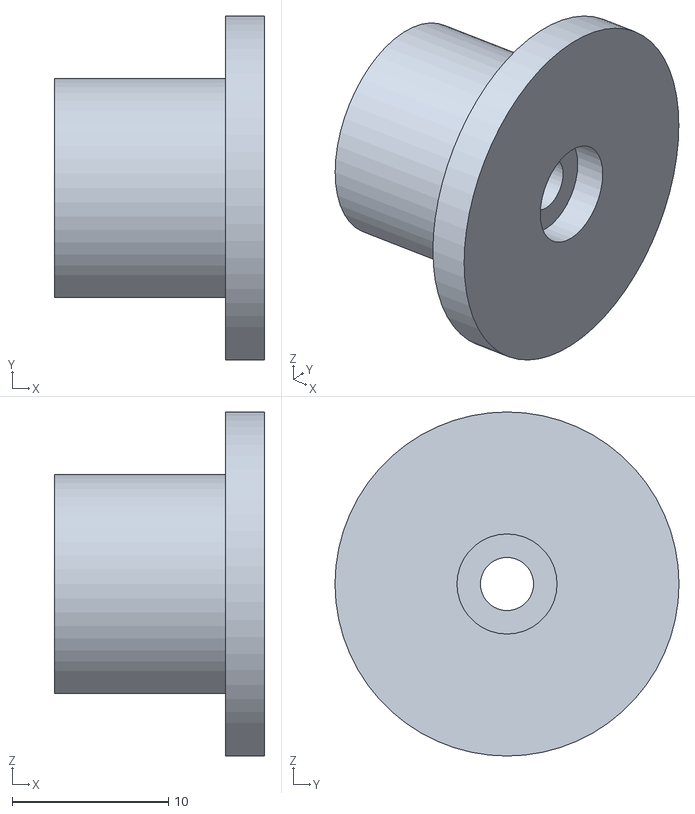
[picture p53: CAD file, 2026-09-24]
exports/v3/h3-pin-shoulder.STL
13.5 x 22.0 x 22.0
