nickthelegend/hotaru/solidworks/parts/MG996R.SLDPRT

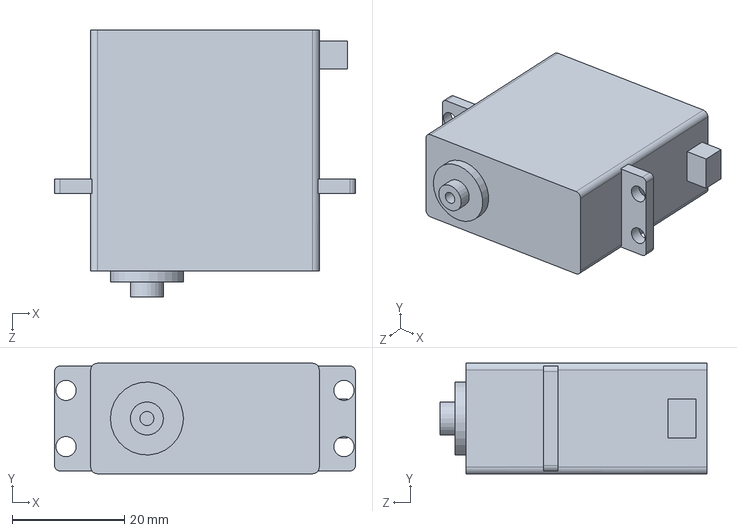
[picture p54: CAD file, 2026-09-24]
solidworks/parts/MG996R.SLDPRT
53.6 x 19.7 x 47.6 mm
