nickthelegend/hotaru/solidworks/parts/Speaker2040.SLDPRT

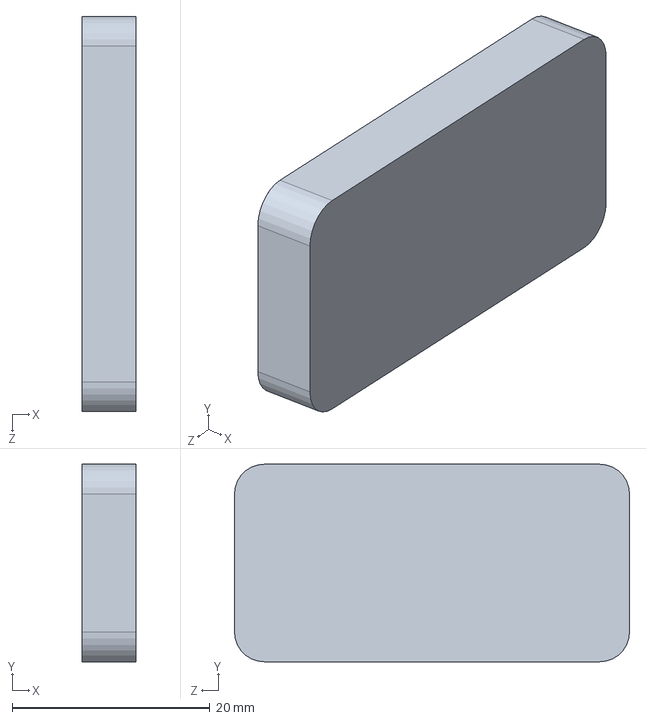
[picture p55: CAD file, 2026-09-24]
solidworks/parts/Speaker2040.SLDPRT
5.50 x 20.0 x 40.0 mm
