nickthelegend/hotaru/solidworks/parts/INMP441.SLDPRT

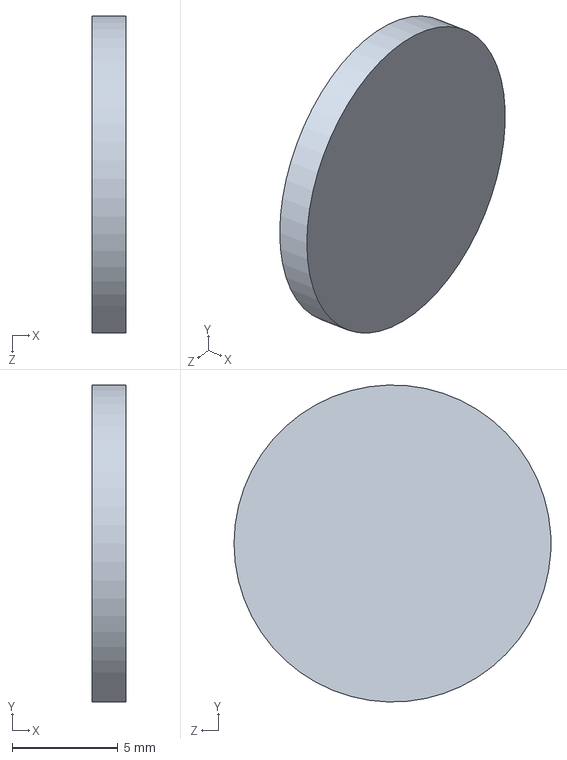
[picture p56: CAD file, 2026-09-24]
solidworks/parts/INMP441.SLDPRT
1.60 x 15.0 x 15.0 mm
