nickthelegend/hotaru/solidworks/parts/WS2812-ring.SLDPRT

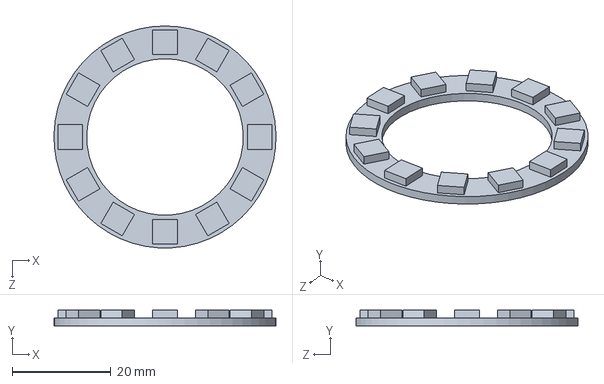
[picture p57: CAD file, 2026-09-24]
solidworks/parts/WS2812-ring.SLDPRT
45.0 x 3.20 x 45.0 mm
