nickthelegend/hotaru/solidworks/parts/h3-head-cover.SLDPRT

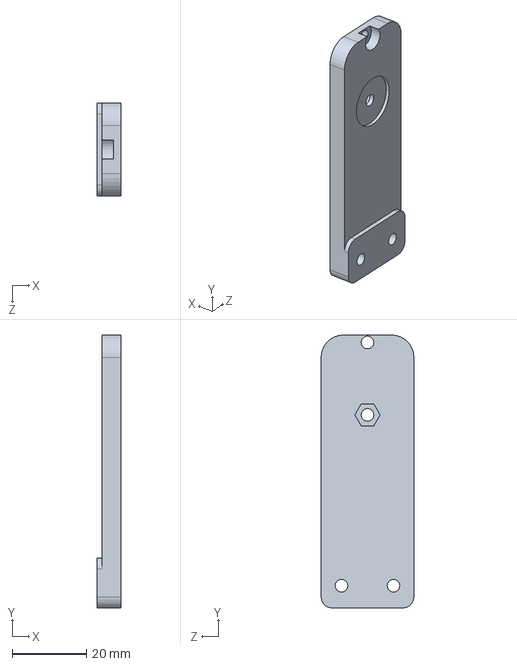
[picture p58: CAD file, 2026-09-24]
solidworks/parts/h3-head-cover.SLDPRT
6.35 x 73.5 x 25.0 mm
