nickthelegend/hotaru/solidworks/parts/Horn.SLDPRT

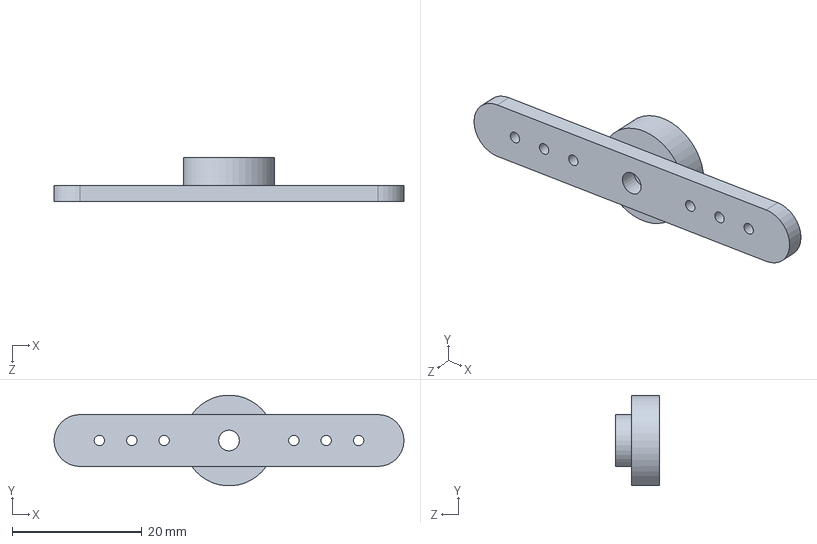
[picture p59: CAD file, 2026-09-24]
solidworks/parts/Horn.SLDPRT
54.0 x 14.0 x 6.80 mm
