nickthelegend/hotaru/solidworks/parts/PCA9685.SLDPRT

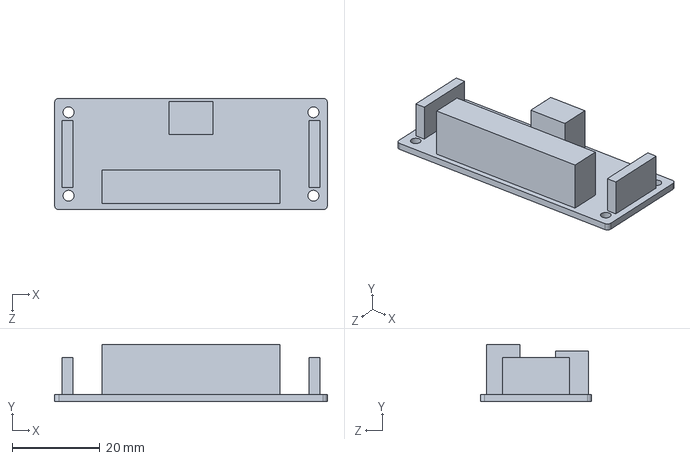
[picture p60: CAD file, 2026-09-24]
solidworks/parts/PCA9685.SLDPRT
62.2 x 13.1 x 25.4 mm
