nickthelegend/hotaru/solidworks/parts/ESP32-S3.SLDPRT

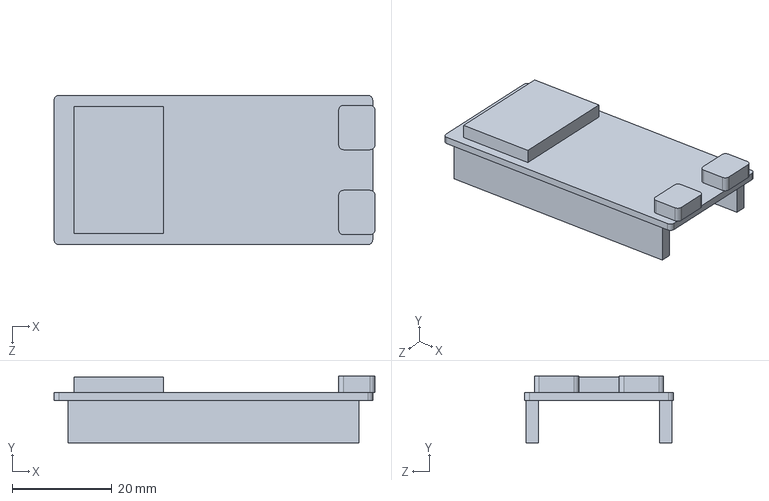
[picture p61: CAD file, 2026-09-24]
solidworks/parts/ESP32-S3.SLDPRT
64.4 x 13.4 x 30.0 mm
