nickthelegend/hotaru/(list of files, cad)

Other CAD files:
exports/v3/plates/HOTARU3-tub-P1S.gcode.3mf
exports/v3/plates/HOTARU3-tub-P1S.3mf
exports/v3/plates/HOTARU3-P1S-project.3mf
exports/v3/plates/plate-1-tub.3mf
exports/v3/h3-pin-elbow.STL
solidworks/parts/h3-pinion.SLDPRT
solidworks/parts/h3-link1-cover.SLDPRT
exports/v3/h3-head.STL
exports/v3/h3-link2-cover.STL
solidworks/parts/h3-ledclamp.SLDPRT
solidworks/parts/h3-lipring.SLDPRT
solidworks/parts/h3-disc.SLDPRT
solidworks/parts/h3-link2.SLDPRT
solidworks/parts/h3-pin-head.SLDPRT
solidworks/parts/h3-link1.SLDPRT
solidworks/parts/h3-pin-elbow.SLDPRT
solidworks/parts/h3-keycap.SLDPRT
solidworks/parts/h3-shade.SLDPRT
solidworks/parts/h3-pin-shoulder.SLDPRT
exports/v2/shade.stl
exports/v2/v2-bolts.stl
exports/v2/v2-clamps.stl
exports/v2/v2-conecap.stl
exports/v2/v2-disc.stl
exports/v2/v2-disckeys.stl
exports/v2/v2-head.stl
exports/v2/v2-keycap.stl
exports/v2/v2-link1-in.stl
exports/v2/v2-link1-ledges.stl
exports/v2/v2-link1-out.stl
exports/v2/v2-link1-spacers.stl
exports/v2/v2-link2-in.stl
exports/v2/v2-link2-out.stl
exports/v2/v2-link2-spacers.stl
exports/v2/v2-plate-1-base.stl
exports/v2/v2-plate-2-arm.stl
exports/v2/v2-plate-3-turntable.stl
exports/v2/v2-plate-4-cone.stl
exports/v2/v2-screws.stl
exports/v2/v2-tower.stl
exports/v2/v2-tub.stl
exports/v3/plates/plate-1-tub.stl
exports/v3/plates/plate-2-lipring-and-pins.stl
exports/v3/plates/plate-3-turntable.stl
exports/v3/plates/plate-4-arm.stl
exports/v3/plates/plate-5-head-and-shade.stl
exports/v3/print/h3-disc.stl
exports/v3/print/h3-head-cover.stl
exports/v3/print/h3-head.stl
exports/v3/print/h3-keycap.stl
exports/v3/print/h3-ledclamp.stl
exports/v3/print/h3-link1-cover.stl
exports/v3/print/h3-link1.stl
exports/v3/print/h3-link2-cover.stl
exports/v3/print/h3-link2.stl
exports/v3/print/h3-lipring.stl
exports/v3/print/h3-pin-elbow.stl
exports/v3/print/h3-pin-head.stl
exports/v3/print/h3-pin-shoulder.stl
exports/v3/print/h3-pinion.stl
exports/v3/print/h3-shade.stl
exports/v3/print/h3-tower.stl
exports/v3/print/h3-tub.stl
solidworks/parts/M3-nut.SLDPRT
solidworks/parts/M3x10.SLDPRT
solidworks/parts/M3x12.SLDPRT
solidworks/parts/M3x16.SLDPRT
solidworks/parts/M3x8.SLDPRT
solidworks/parts/MAX98357A.SLDPRT
