nickthelegend/hotaru/docs/hotaru3-wiring.html

HOTARU 3 · electronics

# HOTARU 3 Wiring

Everything that lives in the tub, and what connects to what, exactly as the HOTARU 3 firmware expects it (firmware/hotaru/config.h). Hold the button and talk: the lamp answers out loud and acts the answer out.

## Schematic

5 V servo rail GND 3V3 logic SDA SCL signal I²S audio speaker

## Pin by pin

Pin | Connects to | Notes
PCA9685 servo driver
VCC | ESP32 3V3 | Logic power only
GND | ESP32 GND | Common ground, always
SDA | ESP32 GPIO 8 | I²C at 400 kHz
SCL | ESP32 GPIO 9
V+ terminal | Servo supply + | 5 V, 3 A or more, with the 2200 µF across V+ and GND at this terminal. Nothing else on this rail.
GND terminal | Servo supply − | And joined to the ESP32's GND, so servo current goes straight back to its supply
CH 0 – 3 | Pan, shoulder, elbow, head | See the servo table below
OE, address pads | Leave open | The firmware expects address 0x40
Cherry MX button
leg 1 | ESP32 GPIO 4 | Internal pull-up. Hold to talk, tap for a gesture; held at power-up, the servos stay off
leg 2 | GND
INMP441 microphone
SCK | ESP32 GPIO 5 | I²S bit clock
WS | ESP32 GPIO 6 | I²S word select
SD | ESP32 GPIO 7 | I²S data out of the mic
L/R | GND | Left channel
VDD / GND | 3V3 / GND | 3.3 V only
MAX98357A amplifier
BCLK | ESP32 GPIO 15 | Its own I²S port, separate from the mic
LRC | ESP32 GPIO 16
DIN | ESP32 GPIO 17
VIN / GND | ESP32 5V / GND | Not the servo rail
SD, GAIN | Leave open | On, both channels mixed, 9 dB gain
+ / − | Speaker | Bridged output: never tie − to GND
WS2812 ring, 12 LEDs
DIN | ESP32 GPIO 18 | The ring's input pad, not DOUT
5V / GND | ESP32 5V / GND | Up to 0.7 A at full white; the firmware keeps it far below that

The audio and LED pins avoid the ESP32-S3's strapping pins (0, 3, 45, 46), USB (19, 20) and the flash and PSRAM pins (26–37). To move one, change it in config.h.

## Servo leads

Channel | Joint | Lead runs | Servo angle at joint 0
CH 0 | Pan, in the tub between the pillars | Out of the cable notch at the bottom of the right pillar, straight to the PCA9685 | 90° (1500 µs)
CH 1 | Shoulder, in the tower (geared 1.8 : 1), range 0–125° | Down the kidney slot in the tower base and the disc, into the tub | 0° (500 µs), upright
CH 2 | Elbow, inside link 1, range 0–120° | Down link 1, then the kidney slot | 0° (500 µs), straight
CH 3 | Head, inside the head block | Out of the head's lead channel, down link 2 and link 1, then the kidney slot | 90° (1500 µs)

On the PCA9685 headers, brown goes on the GND row at the board edge, red on V+, orange on PWM. Leave slack at every joint: the turntable pans ±90° and the arm folds, so a tight lead will pull. Calibration lives on the lamp: cal shows it, cal save keeps changes.

## Power and first switch-on

### Power rules

- The servos get their own 5 V supply, 3 A or more, on the PCA9685's V+ terminal and nothing else.
- All grounds join: servo supply, ESP32, PCA9685, amp, mic, ring, button.
- 2200 µF across V+ and GND at the PCA9685 terminal, stripe to GND.
- The servo supply's + must not touch the ESP32's 5V or 3V3 or the PCA9685's VCC.
- On a laptop's USB alone, hold the MX key while plugging in: the servos stay off. Starting four MG996Rs from USB makes the laptop cut the port.

### First power-up

1. Put your Wi-Fi and keys in secrets.h, then flash firmware/hotaru (ESP32S3 Dev Module, OPI PSRAM, Huge APP).
2. Park the arm folded at rest and power up: the servos engage one at a time, it stretches awake and says hello.
3. Hold the MX key, speak after the beep, let go. A short tap plays a random gesture.
4. Serial monitor at 115200: list shows all 60 actions, ask <text> talks in text, cal shows the calibration. If it prints no PCA9685 at 0x40, check SDA, SCL and VCC.

From HOTARU 3's firmware: firmware/hotaru/config.h (pins and calibration) and firmware/hotaru/README.md (setup, calibration, commands).
