nickthelegend/hotaru/videos/hotaru3-assembly/index.html

SolidWorks CAD · every path checked, 2 mm at a time

Hotaru 3 · assembly

01 / 36 · The base

Before you start

Body

M3x80/1

M3x100/29

M3x120/12

M3x160/6

NUTS0/35

Hotaru 3 · assembly

# Every part. Every bolt.

48 M3 bolts, 35 M3 nuts, zero heat-set inserts. A bolt either runs into a hex nut sitting in a printed pocket, or cuts its own thread in a 2.6 mm pilot hole.

Done

# Built.

48 bolts, 35 nuts, 4 servos, 4 hand cuts and no reprints. Every part's way in was checked in SolidWorks for collisions, 2 mm at a time.
