nickthelegend/hotaru/(commit log)

2026-09-07 fix the STL header my rename broke, and add the check that catches it
    Opening plate 3 in Bambu Studio failed outright:
    "The file does not contain any geometry data."
    A binary STL header is exactly 80 bytes. partlib wrote it as a literal
    label plus a hand-counted 68 nulls, which came to 80 for b"aibo partlib".
    Renaming the project to HOTARU made the label two characters longer, so
    every STL written after that commit had an 82-byte header and the triangle
    count was read two bytes late. The published plates were unopenable, and I
    pushed them saying they were audited and ready to print.
    The geometry was never wrong. All ten audits kept passing, correctly --
    they reason about the MESH and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
    [shade.stl, v2-bolts.stl, v2-clamps.stl, v2-conecap.stl, v2-disc.stl, v2-disckeys.stl, v2-head.stl, v2-keycap.stl]
2026-09-24 HOTARU 3: the lamp rebuilt in SolidWorks, stronger arm, P1S plates
    v2's arm flexed and its shoulder servo was near its limit. HOTARU 3 is
    modelled natively in SolidWorks through its API (sw/), every part a real
    feature tree:
    - shoulder geared 1.8:1 (30T pinion -> 54T gear on link1); the arm turns
    on O14 journal pins, the servo spline carries torque only
    - box-section links, M3 bolts + nuts throughout, no printed threads
    - turntable on a slew ring trapped by a bolted lip ring
    - PCA9685 servo driver in the base; new firmware (firmware/hotaru_motion)
    with synchronised trapezoid moves and a torque/self-collision pose guard
    Checked in SolidWorks: 12 poses over every joint's range, zero
    inte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
2026-10-16 HOTARU 3: the talking lamp firmware, wiring, hand cuts and the assembly video
    firmware/hotaru: the whole lamp on the ESP32-S3. Hold the MX key and talk:
    Deepgram nova-3 hears it, a free OpenRouter model answers as HOTARU with one
    of 60 gestures, a mood and lamp control, and Deepgram aura-2 speaks the reply
    while the arm acts it out. Ring effects for listening, thinking and talking,
    idle fidgets and sleep. Calibrated in servo degrees (shoulder 0..125 through
    the 1.8:1 gear, elbow 0..120), adjustable and saved on the lamp over serial.
    The motion core (pose guard, route planner, trapezoid moves) runs in its own
    FreeRTOS task. Keys and Wi-Fi live in secrets.h, which is git-ignored;
    secrets.examp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
